pieterpottie/flim-transport-project/Documents/designReport_2.docx

Department of Mechanical Engineering

Engr 466 Design Report 2

Authors: | Anderson Li Andrew Bornstein
Filename: | designReport_1
Date: | 25-May-2012
Total Pages: | 32

Table of Contents

Table of Figures

List of Tables

# 1 Introduction

## 1.1 Current State of the Project

## 1.2 Objectives of this Report

KEEP THINGS CONCISE. GO THROUGH THE DESIGN IN DETAIL BUT ONLY SAY WHAT YOU HAVE TO. SAY IT DIRECTLY AND SIMPLY.

# 2 Final Design Description

This section should be pretty short. Give a detailed description of how each design component will operate and the parts that make it up. keep it brief and general. Tell them what the component is, what it does, the parts that make it up to achieve its purpose

-Film transport

-2 sprockets, R=23.8mm. cnc milled from aluminum

-driven by a stepper motor.. 50 steps per frame. Stepper motor circuit…independent control diagram…(or should this be in the later sections…)…

-Up/outtake

-film gate

-tensioner

-LED illumination

-photo mount

-frame layout (this can mostly go in design mechanical interfacing)

…. maybe

# 3 Detailed Mechanical Overview

Drawings for each mechanical component

Describe how things attach, bolt sizes ect.

Assembly drawing of the system

# 4 Design Component Interfacing

…the mechanical interfacing.. spacing between film gate and sprockets.. how things are layed out on the frame ex, so the tensioner will fit and operate. (basically a detailed discussion of the frame)

Identify all the interface circuits

Identify the software relationships between

# 5 Electrical Design

-individual circuits and the power requirements, operating parameters for our actuators/sensors

-giant system circuit

# 6 Preliminary Software Design

-system flow chart

-flow chart for the components (like in that 230 assignment)

# 7 Conclusions

-current challenges we are facing and how we are attacking it.

-our next steps

# References

1. EarthEasy. [Online] [Cited: May 24, 2012.] http://eartheasy.com/live_led_bulbs_comparison.html.

2. Flatbed Scanner Digital Telecine (FSDT) Project. [Online] [Cited: May 25, 2012.]

http://www.truetex.com/telecine.htm.

3.Machinist-Materials, Plastics Comparison Table [Online] [Cited: May 25, 2012] http://www.machinist-materials.com/comparison_table_for_plastics.htm.

4. Omnia Plastica ABS Acrylonitrile-butadiene-styrene. [Online][Cited: May 25, 2012] http://www.matweb.com/search/datasheet.aspx?matguid=f6c2155e247b427d8bedaad7620b4c37&ckck=1.

5. 1 -1/4” Chigaco Screws. [Online][Cited: May 25, 2012] http://www.screwpost.com/product_info.php?cPath=1&products_id=10

6. 1/8” Aluminum Rod Stock. [Online][Cited: May 25, 2012]

http://www.mcmaster.com/#standard-aluminum-rods/=hoo0rc

Engr 466 Design Report 1 Date: 25-May-2012
