pieterpottie/flim-transport-project/Weekly-Reports/Gantt-Chart.xlsx

VX42 (http://www.vertex42.com/ExcelTemplates/excel-gantt-chart.html) | Excel Gantt Chart |  |  |  |  | © 2006 Vertex42 LLC (http://www.vertex42.com/terms.html) | v.1.2
Engr 466 Flim Transport Project
Department of Mechanical Engineering
 | Project Lead:
 | Today's Date: | 2012-07-17 |  | (vertical red line)
 | Viewing Weeks: | 5/7/12 - 4/1/13 |  |  |  |  |  |  |  | 0 | 2012-05-07 | 2012-05-08 | 2012-05-09 | 2012-05-10 | 2012-05-11 | 2012-05-14 | 2012-05-15 | 2012-05-16 | 2012-05-17 | 2012-05-18 | 2012-05-21 | 2012-05-22 | 2012-05-23 | 2012-05-24 | 2012-05-25 | 2012-05-28 | 2012-05-29 | 2012-05-30 | 2012-05-31 | 2012-06-01 | 2012-06-04 | 2012-06-05 | 2012-06-06 | 2012-06-07 | 2012-06-08 | 2012-06-11 | 2012-06-12 | 2012-06-13 | 2012-06-14 | 2012-06-15 | 2012-06-18 | 2012-06-19 | 2012-06-20 | 2012-06-21 | 2012-06-22 | 2012-06-25 | 2012-06-26 | 2012-06-27 | 2012-06-28 | 2012-06-29 | 2012-07-02 | 2012-07-03 | 2012-07-04 | 2012-07-05 | 2012-07-06 | 2012-07-09 | 2012-07-10 | 2012-07-11 | 2012-07-12
WBS | Tasks | Task Lead | Start | End | Duration (Days) | % Complete | Working Days | Days Complete | Days Remaining |  | 5/7/12 |  |  |  |  | 5/14/12 |  |  |  |  | 5/21/12 |  |  |  |  | 5/28/12 |  |  |  |  | 6/4/12 |  |  |  |  | 6/11/12 |  |  |  |  | 6/18/12 |  |  |  |  | 6/25/12 |  |  |  |  | 7/2/12 |  |  |  |  | 7/9/12
 | Design Report 1 |  | 2012-05-07 | 2012-06-01 | 26 | 100% | 20 | 26 | 0
 | Background Research | Andrew | 2012-05-14 | 2012-05-16 | 3 | 100% | 3 | 3 | 0
 | Peripherals Research | Andrew | 2012-05-14 | 2012-05-19 | 6 | 100% | 5 | 6 | 0
 | Actuator Research | Andrew | 2012-05-14 | 2012-05-23 | 10 | 100% | 8 | 10 | 0
 | Sensor Research | Anderson | 2012-05-14 | 2012-05-23 | 10 | 100% | 8 | 10 | 0
 | Frame Design | Anderson & Andrew | 2012-05-14 | 2012-05-25 | 12 | 100% | 10 | 12 | 0
 | Mounting Design | Anderson | 2012-05-16 | 2012-05-25 | 10 | 100% | 8 | 10 | 0
 | Write Report | Anderson & Andrew | 2012-05-07 | 2012-05-25 | 19 | 100% | 15 | 19 | 0
 | Initial Design Concepts | Anderson & Andrew | 2012-05-14 | 2012-05-26 | 13 | 100% | 10 | 13 | 0
 | Client Presentation 1 | Anderson & Andrew | 2012-05-27 | 2012-06-01 | 6 | 100% | 5 | 6 | 0
 | Design Report 2 |  | 2012-05-25 | 2012-06-29 | 36 | 93.75% | 26 | 33 | 3
 | Order Parts | Andrew | 2012-05-25 | 2012-05-25 | 1 | 100% | 1 | 1 | 0
 | Programming | Anderson & Andrew | 2012-05-25 | 2012-06-18 | 25 | 85% | 17 | 21 | 4
 | Refine Design Models | Anderson & Andrew | 2012-06-04 | 2012-06-29 | 26 | 100% | 20 | 26 | 0
 | Setup Electronics | Anderson & Andrew | 2012-06-10 | 2012-06-29 | 20 | 85% | 15 | 17 | 3
 | Write Report | Anderson & Andrew | 2012-05-25 | 2012-06-29 | 36 | 100% | 26 | 36 | 0
 | Prototype Demo |  | 2012-06-08 | 2012-08-03 | 57 | 41.42857143% | 41 | 23 | 34
 | Machine Parts | Anderson & Andrew | 2012-06-09 | 2012-06-24 | 16 | 95% | 10 | 15 | 1
 | Assembly | TBA | 2012-07-04 | 2012-07-13 | 10 | 35% | 8 | 3 | 7
 | Troubleshoot | TBA | 2012-07-13 | 2012-07-27 | 15 | 30% | 11 | 4 | 11
 | Client Presentation 2 | TBA | 2012-07-20 | 2012-08-03 | 15 | 0% | 11 | 0 | 15
 | Final report |  | 2012-07-27 | 2012-08-04 | 9 | 0% | 6 | 0 | 9
 | Write Report | TBA | 2012-07-27 | 2012-08-04 | 9 | 0% | 6 | 0 | 9
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
