pieterpottie/flim-transport-project/Design-Reports/Report-1/comparison-charts.xlsx

 | Frame Precision | Ease of Manufacture | Size | Tooth/film contact ratio | Minimize stress applied to film | Total Score
Small Sproket | 9 | 2 | 9 | 2 | 2 | 24
Medium Sproket | 7 | 3 | 7 | 7 | 6 | 30
Large Sproket | 3 | 4 | 3 | 9 | 9 | 28
Max Score | 10 | 10 | 10 | 10 | 10
 | Low Cost | Time it takes to make parts | Minimize friction applied to film | Total Score
Pins | 10 | 8 | 2 | 20
Purchased Sleeve Bearings | 2 | 10 | 15 | 27
Machined Sleeve Bearings | 10 | 4 | 17 | 31
Max Score | 10 | 10 | 20
 | Frame Transport Accuracy | Low Cost | Ease of Machining and Assembly | Available Feedback | Minimize stress applied to film | Total Score
Stepper Motor | 8 | 9 | 9 | 0 | 5 | 31
Geneva Mechanism | 3 | 3 | 5 | 0 | 2 | 13
Servo Motor | 3 | 4 | 3 | 10 | 5 | 25
Max Score | 10 | 10 | 10 | 10 | 10
 | Low Cost | Easy Control System | Minimize Friction applied to film | Total Score
Tension Sensor | 1 | 3 | 2 | 6
Optical Encoder | 10 | 8 | 10 | 28
Max Score | 10 | 10 | 10
