pieterpottie/flim-transport-project/Models/A002_Film-Gate/A002_assemDesign1.SLDASM

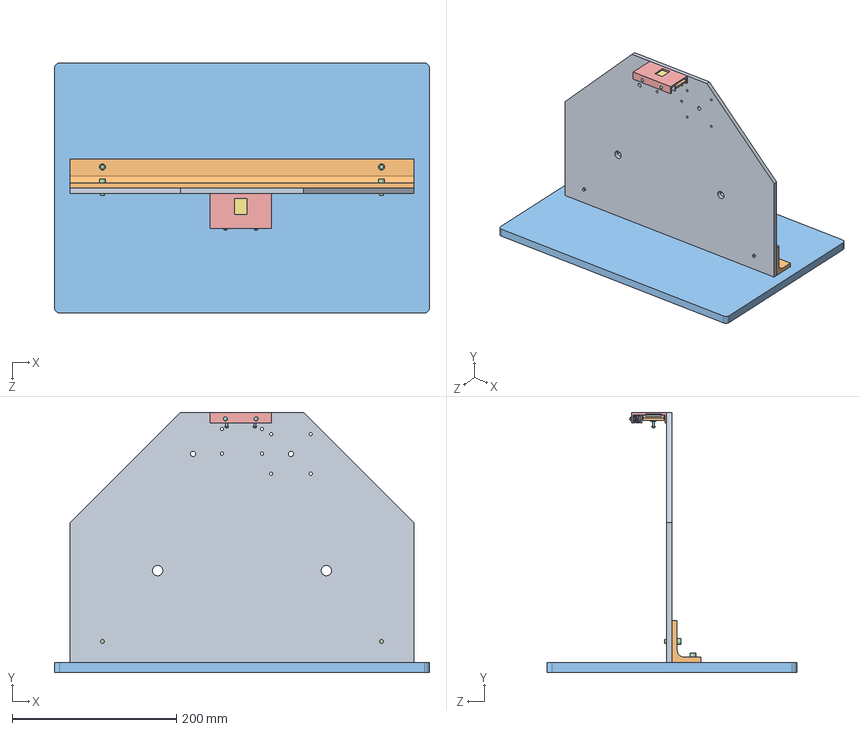
[picture p156: CAD file, 2012-05-22]
Models/A002_Film-Gate/A002_assemDesign1.SLDASM
457.2 x 317.5 x 304.8 mm
A001_frame
A001_LBracket
A001_base
A001_screw x 4
A002-B001_base
A002-B001_tensioner
virtualFilmModel^A002-B001_assem
A002-B001_screw x 4
A002-B001_spring x 2
A002-B001_topTensioner
