pieterpottie/flim-transport-project/Models/A002_Film-Gate/B001_Design-1/A002-B001_assem.SLDASM

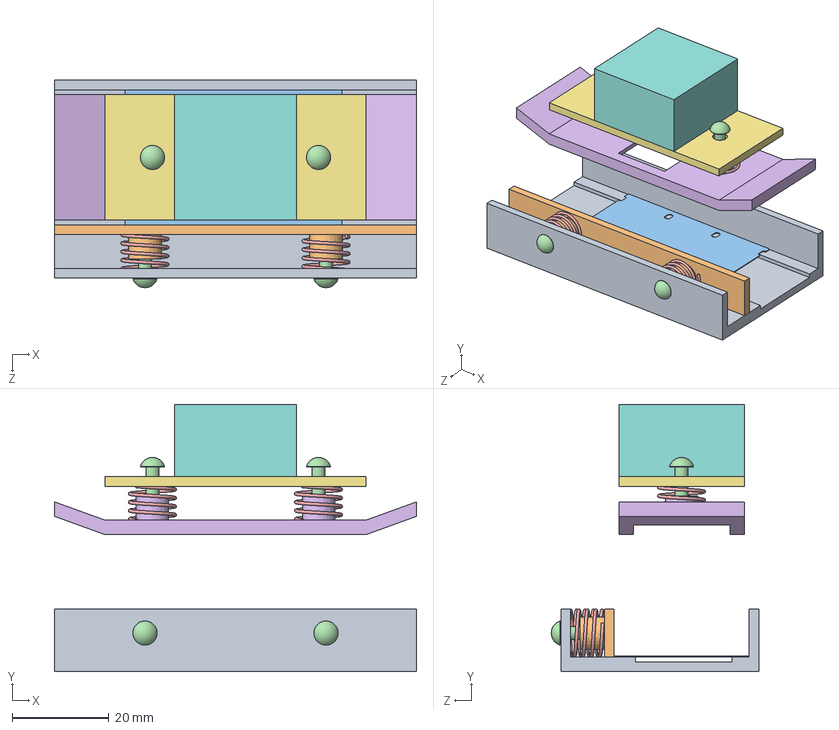
[picture p157: CAD file, 2012-05-23]
Models/A002_Film-Gate/B001_Design-1/A002-B001_assem.SLDASM
75.0 x 55.4 x 43.0 mm
A002-B001_base
A002-B001_tensioner
virtualFilmModel^A002-B001_assem
A002-B001_screw x 4
A002-B001_spring x 4
A002-B001_topTensioner
A002-B001_LEDMount
A002-B001_LEDs
