pieterpottie/flim-transport-project/Models/A002_Film-Gate/B002_Design-2/A002-B002_assem.SLDASM

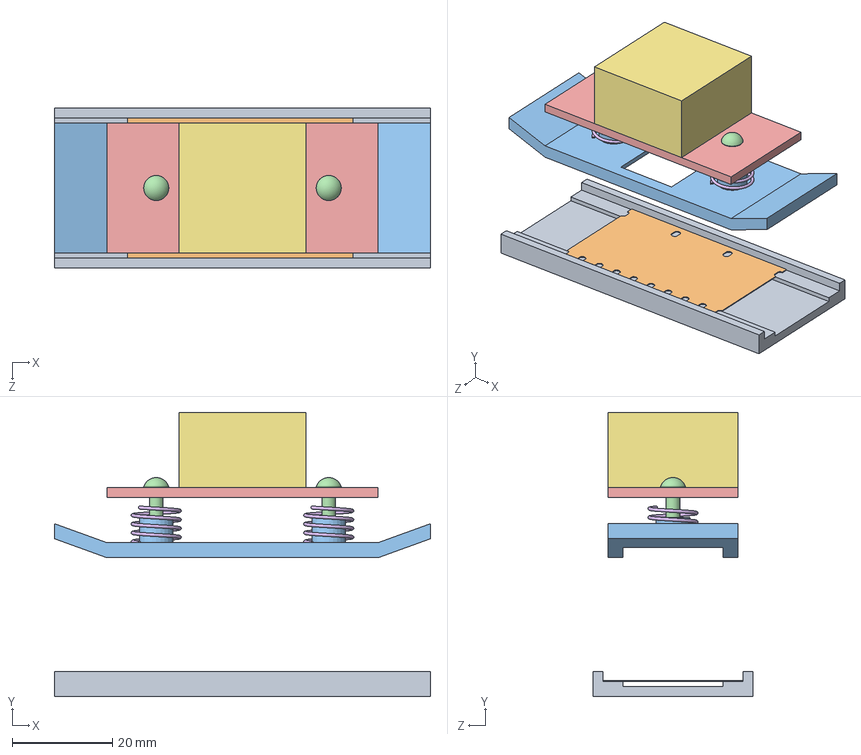
[picture p158: CAD file, 2012-05-24]
Models/A002_Film-Gate/B002_Design-2/A002-B002_assem.SLDASM
75.0 x 56.7 x 32.0 mm
A002-B002_base
virtualFilmModel^A002-B002_assem
A002-B002_topTensioner
A002-B002_screw x 2
A002-B002_LEDMount
A002-B002_spring x 2
A002-B002_LEDs
