pieterpottie/flim-transport-project/Models/A003_Frame-Designs/A003_FrameDesign2.SLDASM

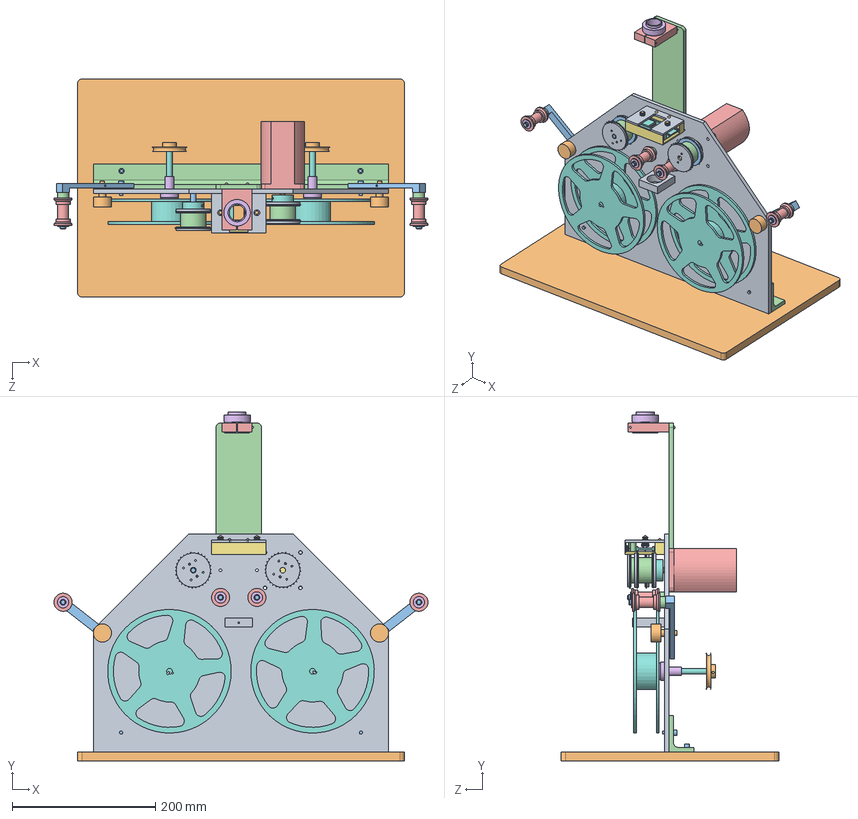
[picture p159: CAD file, 2012-08-03]
Models/A003_Frame-Designs/A003_FrameDesign2.SLDASM
522.9 x 487.8 x 304.8 mm
A001_frame
A001_base
A001_screw x 4
A001_LBracket
StepperModel
Brass_Bushing x 2
Coupling rod x 2
Coupler x 2
OuterSandwich_THICK x 4
R23.87mmSprocketCoarse x 2
OuterSandwich_THIN x 4
LongInnerSpacer x 2
R23.87mmSprocketFine x 2
Sprocket_Pin x 4
6-32_Set_Screw x 4
ReelRod x 2
ReelKey x 2
LargePulleyRoller x 2
RollerPin x 5
DelrinSpacer x 4
RollerPLASTICSECTION x 4
DelrinWasher x 4
A002-B003_base
A002-B003_topTensioner
A002-B003_TensionMount
A002-B003_screw x 6
A002-B003_spring x 2
A002-B003_tensioner x 2
A002-B003_spring-2 x 2
A002-B003_Post x 2
A002-B003_Brace x 2
FilmWheelModel x 2
A004_LED-Mount
Potentiometer x 2
A004_Tensioner-bracket x 2
A004_Adapter_Holder2
A004_Adapter_Holder
A004_Adapter
