pieterpottie/flim-transport-project/Models/A001_Frame-From-Art/A001_assem.SLDASM

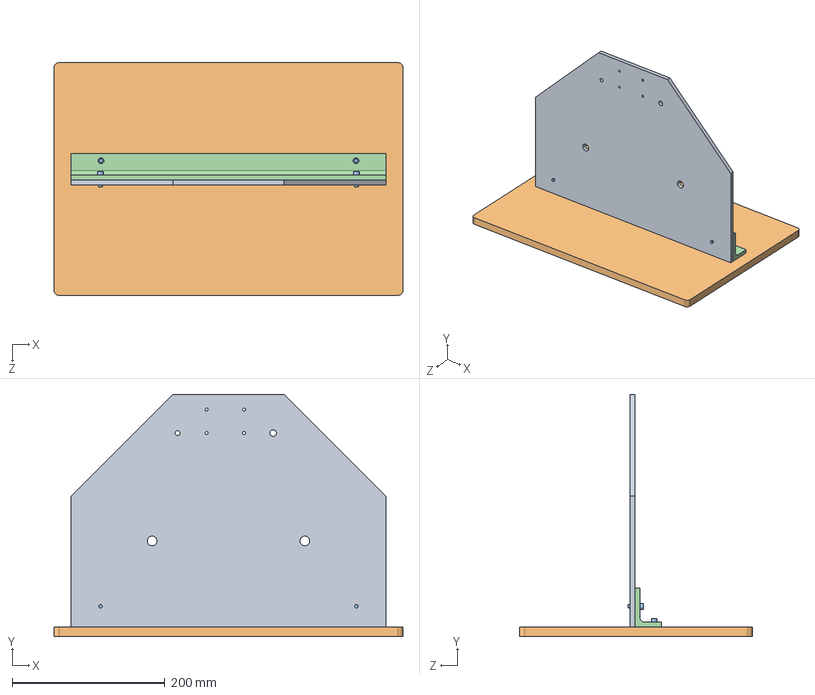
[picture p160: CAD file, 2012-07-12]
Models/A001_Frame-From-Art/A001_assem.SLDASM
457.2 x 317.5 x 304.8 mm
A001_frame
A001_base
A001_screw x 4
A001_LBracket
