pieterpottie/flim-transport-project/Andrew Models Import/TelecineAssembly.SLDASM

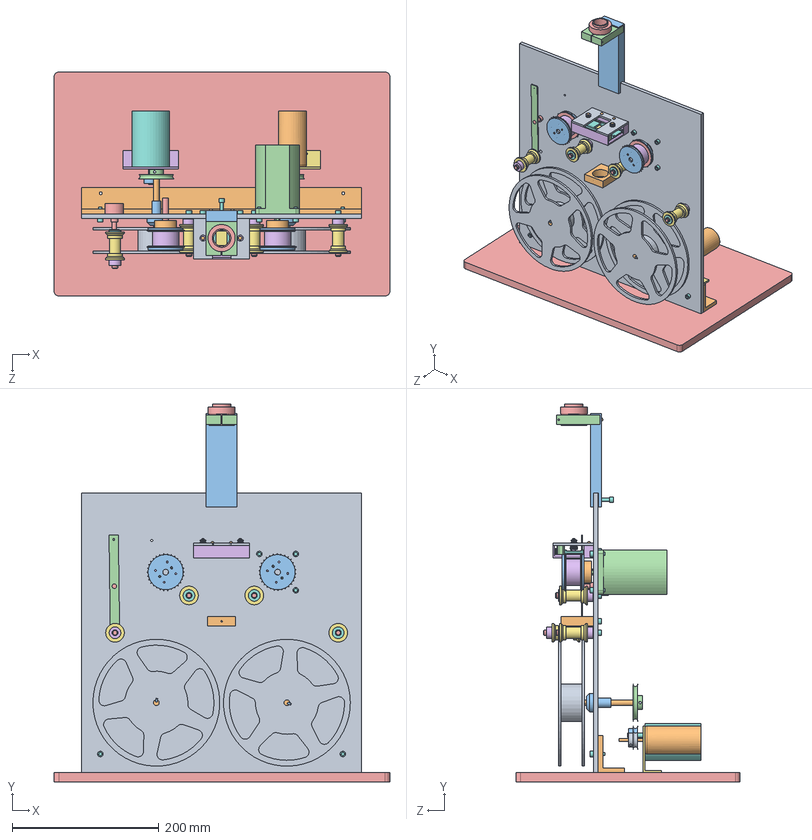
[picture p161: CAD file, 2012-07-12]
Andrew Models Import/TelecineAssembly.SLDASM
457.2 x 514.7 x 304.8 mm
Frame
StructureAngle
Brass_Bushing x 2
StepperModel
RollerPin x 5
DelrinSpacer x 4
RollerPLASTICSECTION x 4
DelrinWasher x 4
Coupling rod x 2
Coupler x 2
OuterSandwich_THICK x 4
R23.87mmSprocketCoarse x 2
OuterSandwich_THIN x 4
LongInnerSpacer x 2
R23.87mmSprocketFine x 2
Sprocket_Pin x 4
6-32_Set_Screw x 6
ReelRod x 2
ReelKey x 2
LargePulleyRoller x 2
GE_restricted
Wimpy_Faithful
Ge_Motor
SmallPulleyRoller_4mm
Wimpy_Motor
SmallPulleyRoller
TensionArm
Potentiometer
A002-B003_base
virtualFilmModel^A002-B003_assem
A002-B003_topTensioner
A002-B003_TensionMount
A002-B003_screw x 6
A002-B003_spring x 2
A002-B003_tensioner x 2
A002-B003_spring-2 x 2
A002-B003_Post x 2
A002-B003_Brace x 2
A001_screw x 13
FilmWheelModel x 2
A004_LED-Mount
A004_Adapter_Holder2
A004_Adapter_Holder
A004_Adapter
