pieterpottie/flim-transport-project/Models/A003_Frame-Designs/A003_Existing_Art_Frame.SLDASM

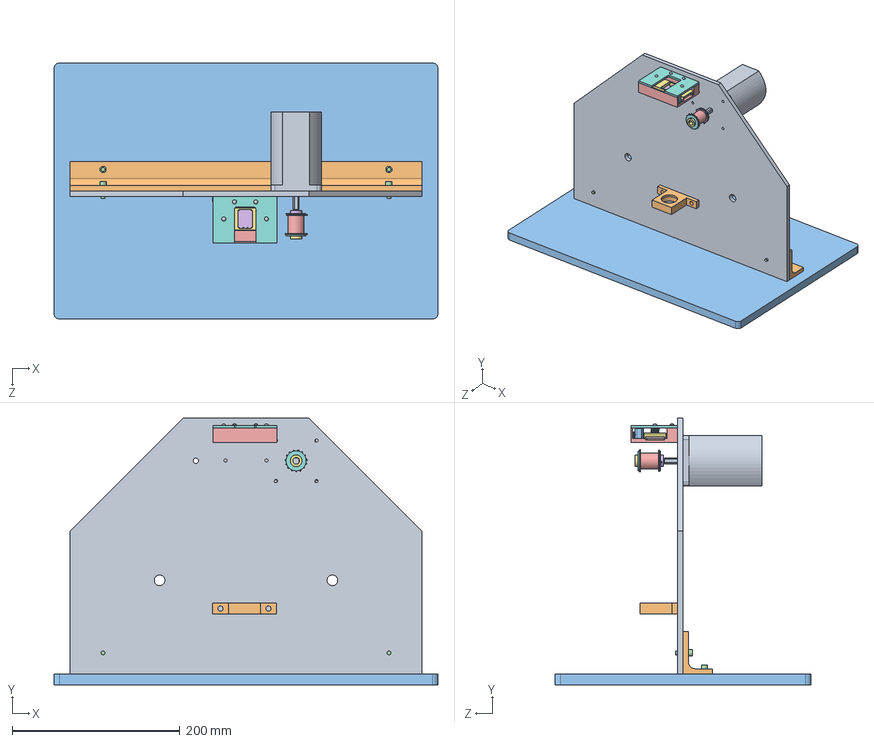
[picture p162: CAD file, 2012-06-18]
Models/A003_Frame-Designs/A003_Existing_Art_Frame.SLDASM
457.2 x 317.5 x 304.8 mm
A001_frame
A001_LBracket
A001_base
A001_screw x 4
A002-B003_base
virtualFilmModel^A002-B003_assem
A002-B003_topTensioner
A002-B003_TensionMount
A002-B003_screw x 4
A002-B003_spring x 2
A002-B003_tensioner x 2
A002-B003_spring-2 x 2
innerSandwich_3quarterdia_looseFit
MajorSprocket23mm
MinorSprocket23mm
OuterSandwich_PressFit x 2
StepperModel
A004_LED-Mount
