pieterpottie/flim-transport-project/Models/A002_Film-Gate/B003_Design-3/A002-B003_assem.SLDASM

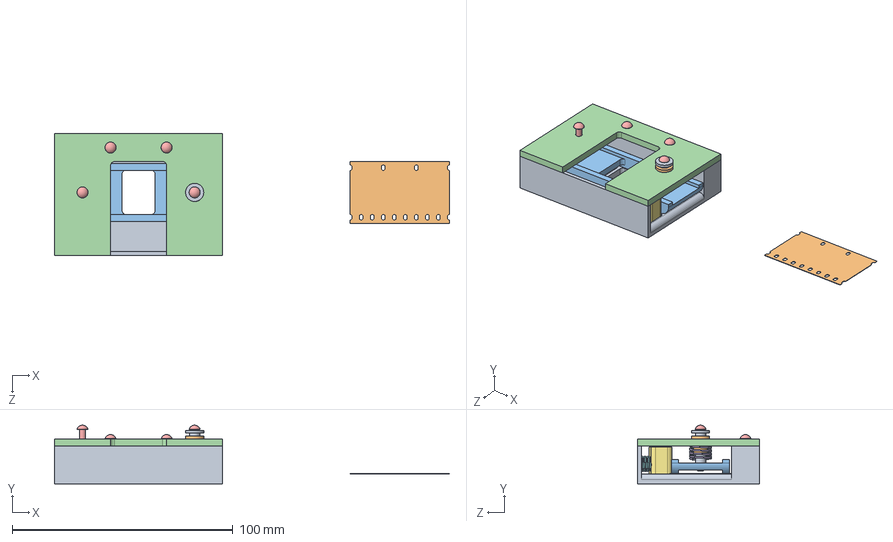
[picture p163: CAD file, 2012-08-03]
Models/A002_Film-Gate/B003_Design-3/A002-B003_assem.SLDASM
178.9 x 26.6 x 55.2 mm
A002-B003_base
virtualFilmModel
A002-B003_topTensioner
A002-B003_TensionMount
A002-B003_screw x 4
A002-B003_spring x 2
A002-B003_tensioner x 2
A002-B003_spring-2 x 2
