pieterpottie/flim-transport-project/Models/A004_Mounts/A004_CameraAssembly.SLDASM

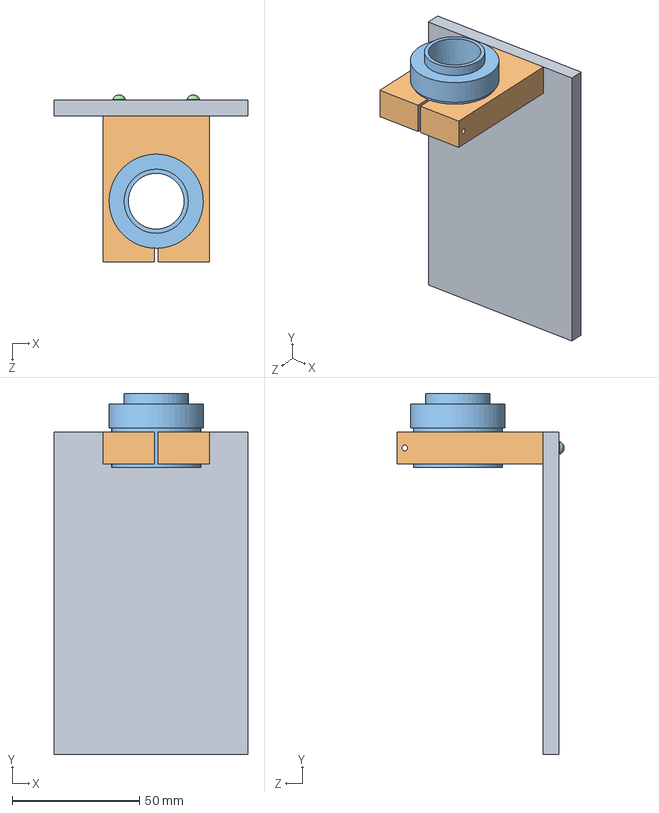
[picture p164: CAD file, 2012-07-12]
Models/A004_Mounts/A004_CameraAssembly.SLDASM
76.2 x 142.1 x 65.9 mm
A004_Adapter_Holder2
A004_Adapter_Holder
A004_Adapter
A002-B003_screw x 2
