pieterpottie/flim-transport-project/Andrew Models Import/ReelAssembly.SLDASM

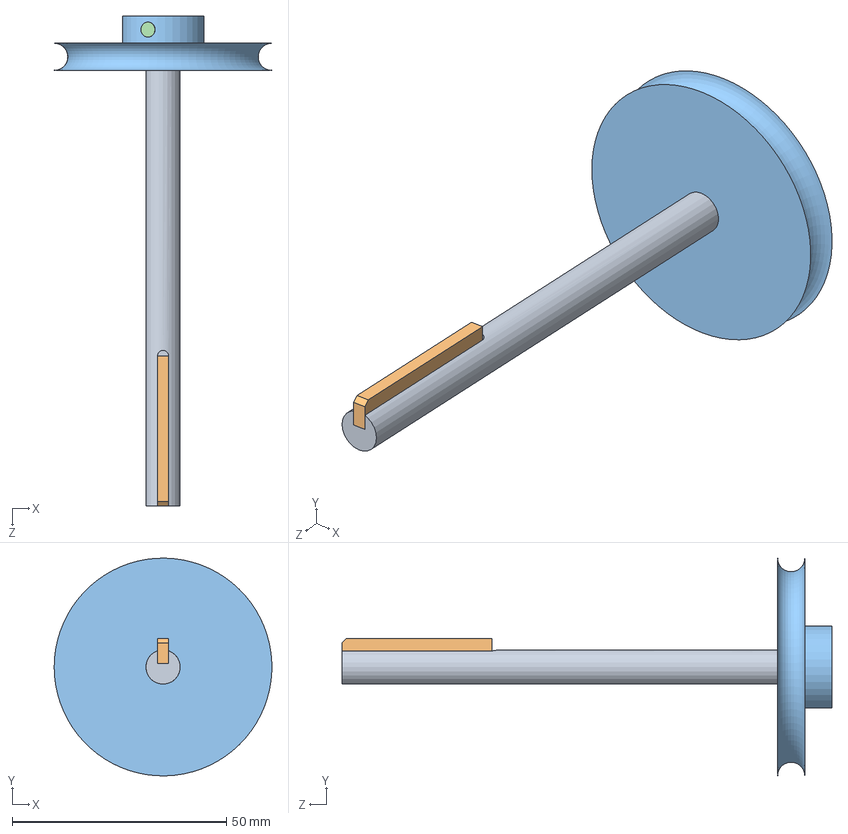
[picture p165: CAD file, 2012-07-03]
Andrew Models Import/ReelAssembly.SLDASM
50.8 x 50.8 x 114.3 mm
ReelRod
ReelKey
LargePulleyRoller
6-32_Set_Screw
