pieterpottie/flim-transport-project/Andrew Models Import/SprocketAssembly.SLDASM

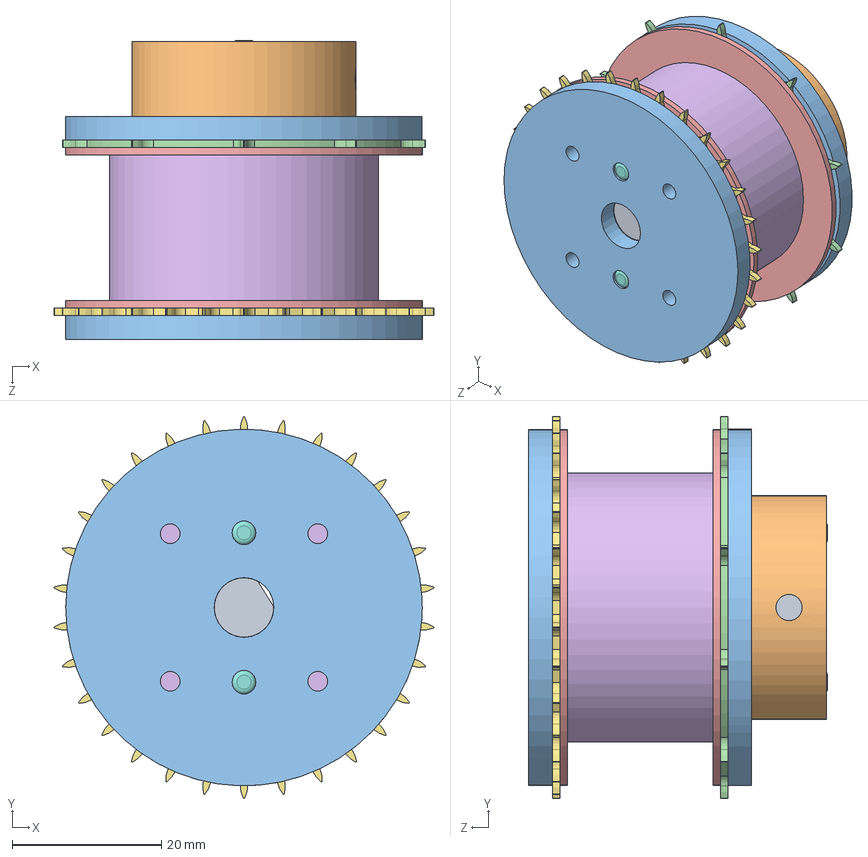
[picture p166: CAD file, 2012-07-03]
Andrew Models Import/SprocketAssembly.SLDASM
50.9 x 51.2 x 40.0 mm
Coupling rod
Coupler
OuterSandwich_THICK x 2
R23.87mmSprocketCoarse
OuterSandwich_THIN x 2
LongInnerSpacer
R23.87mmSprocketFine
Sprocket_Pin x 2
6-32_Set_Screw
