pieterpottie/flim-transport-project/Andrew Models Import/Assem3.SLDASM

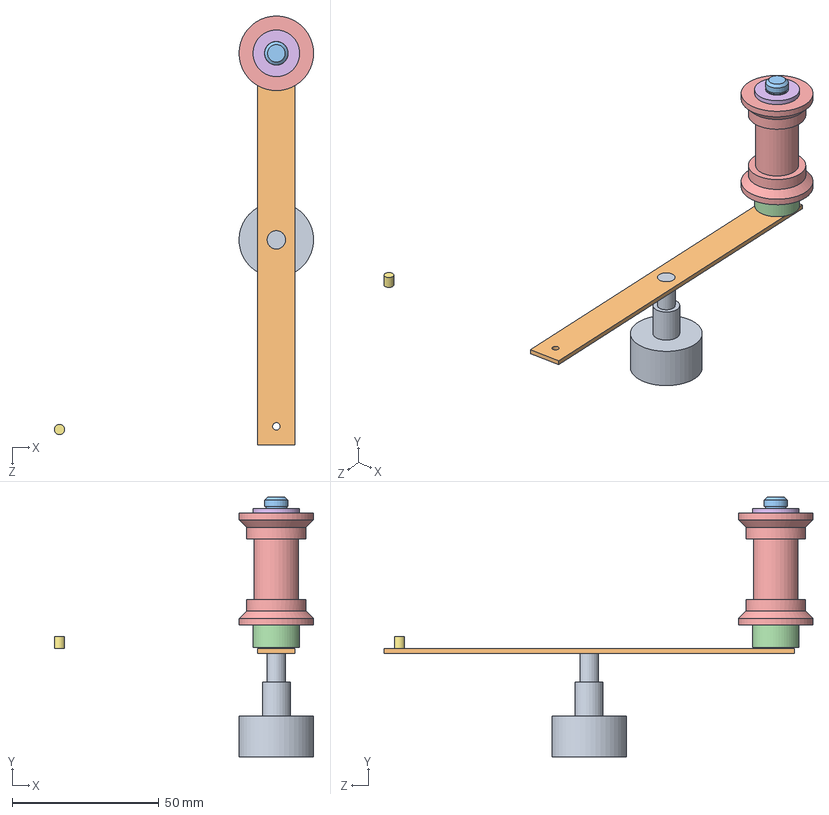
[picture p167: CAD file, 2012-07-03]
Andrew Models Import/Assem3.SLDASM
88.3 x 88.4 x 146.1 mm
Potentiometer
TensionArm
RollerPin
DelrinSpacer
RollerPLASTICSECTION
DelrinWasher
6-32_Set_Screw
