pieterpottie/flim-transport-project/Andrew Models Import/RollerAssembly.SLDASM

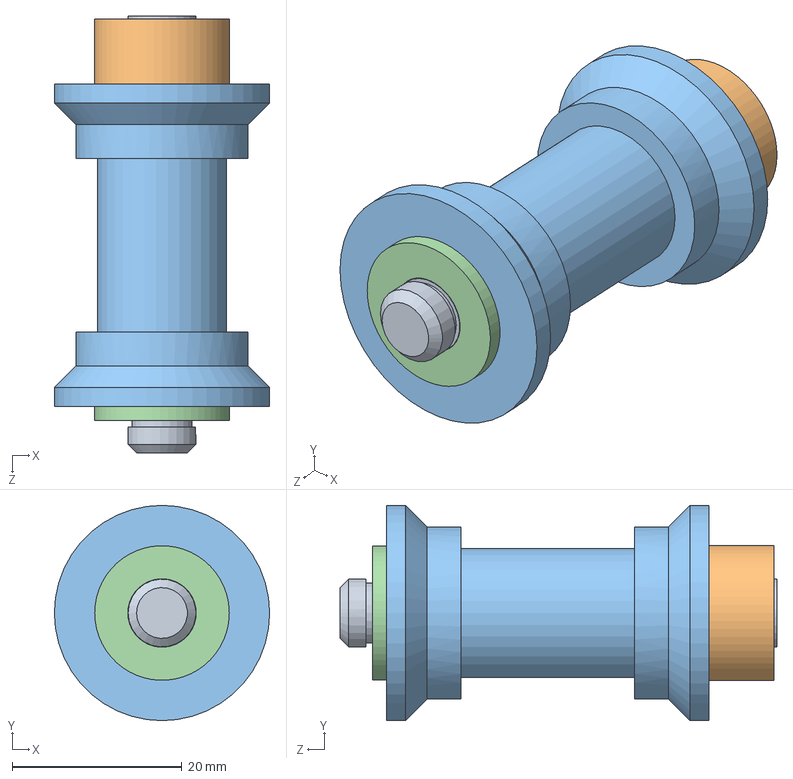
[picture p168: CAD file, 2012-07-03]
Andrew Models Import/RollerAssembly.SLDASM
25.4 x 25.4 x 51.6 mm
RollerPin
DelrinSpacer
RollerPLASTICSECTION
DelrinWasher
