pieterpottie/flim-transport-project/Andrew Models Import/Frame_Assembly.SLDASM

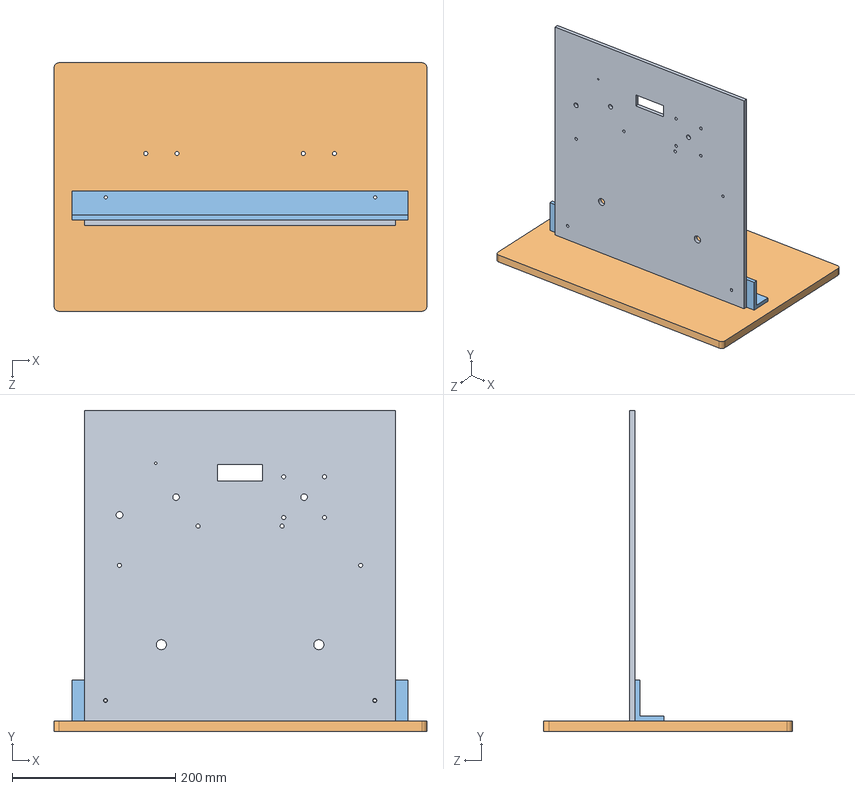
[picture p169: CAD file, 2012-07-03]
Andrew Models Import/Frame_Assembly.SLDASM
457.2 x 393.7 x 304.8 mm
Frame
Base
StructureAngle
