pieterpottie/flim-transport-project/Andrew Models Import/ANDREW_DCMOTOR_MOUNTS/Base.SLDPRT

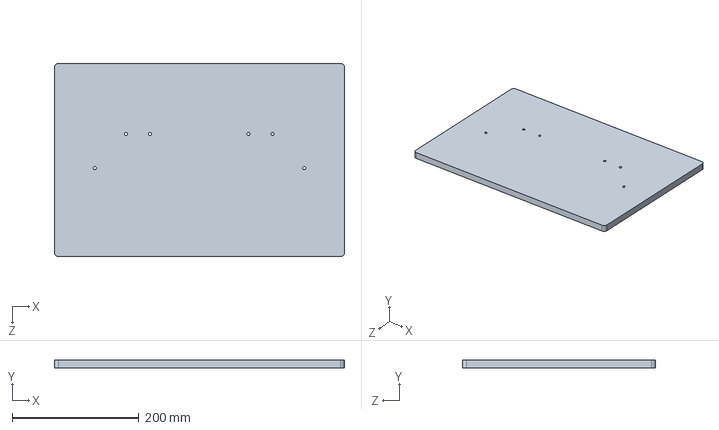
[picture p170: CAD file, 2012-07-05]
Andrew Models Import/ANDREW_DCMOTOR_MOUNTS/Base.SLDPRT
457.2 x 12.7 x 304.8 mm
