pieterpottie/flim-transport-project/Andrew Models Import/Brass_Bushing.SLDPRT

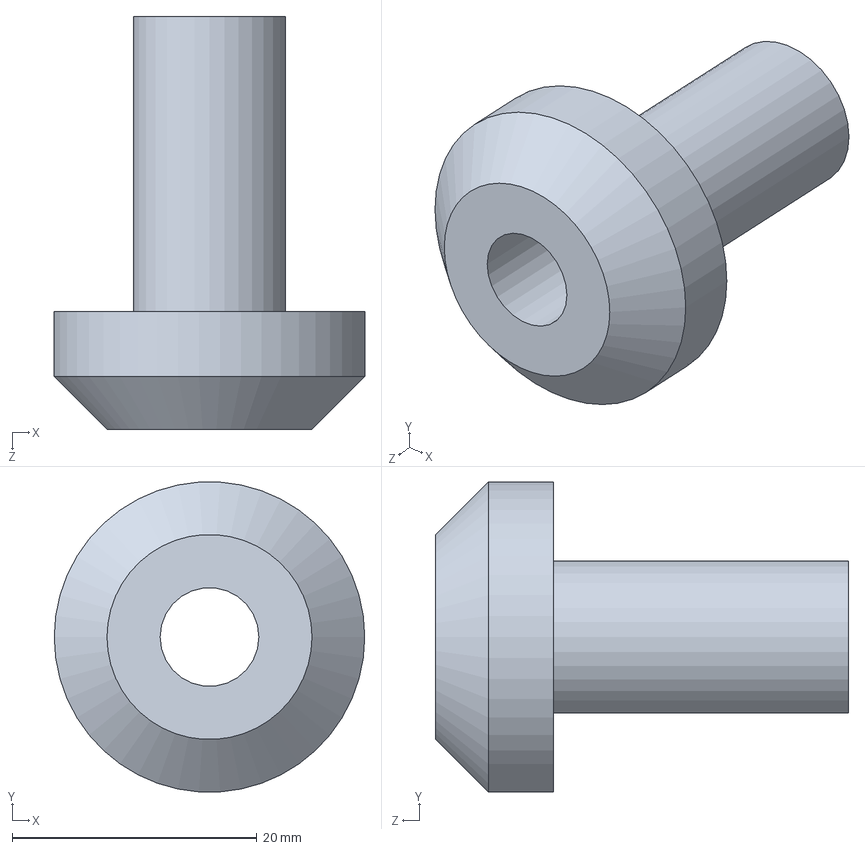
[picture p171: CAD file, 2012-07-12]
Andrew Models Import/Brass_Bushing.SLDPRT
25.4 x 25.3 x 33.8 mm
