pieterpottie/flim-transport-project/Andrew Models Import/PrintSprock/OuterSandwich_PressFit.SLDPRT.STL

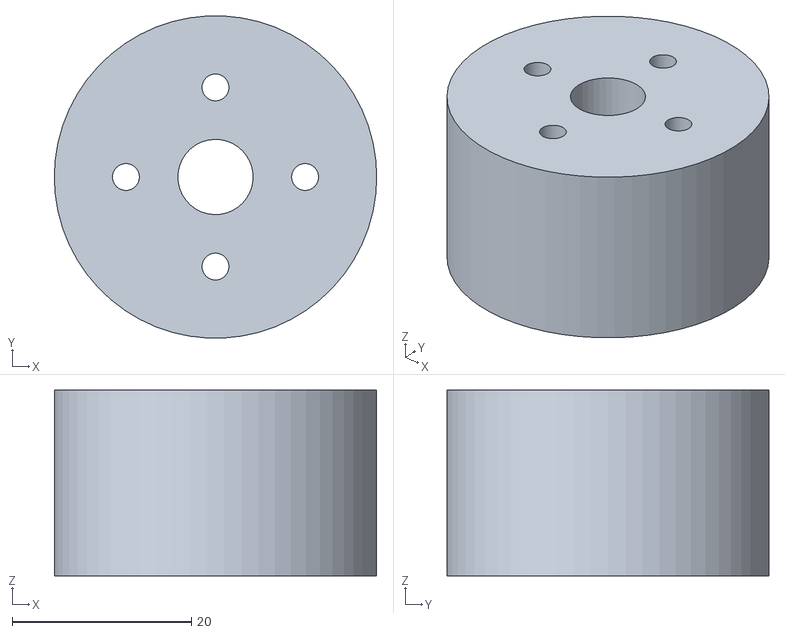
[picture p172: CAD file, 2012-07-03]
Andrew Models Import/PrintSprock/OuterSandwich_PressFit.SLDPRT.STL
36.0 x 35.9 x 20.7
