pieterpottie/flim-transport-project/Models/A001_Frame-From-Art/A001_frame.SLDPRT

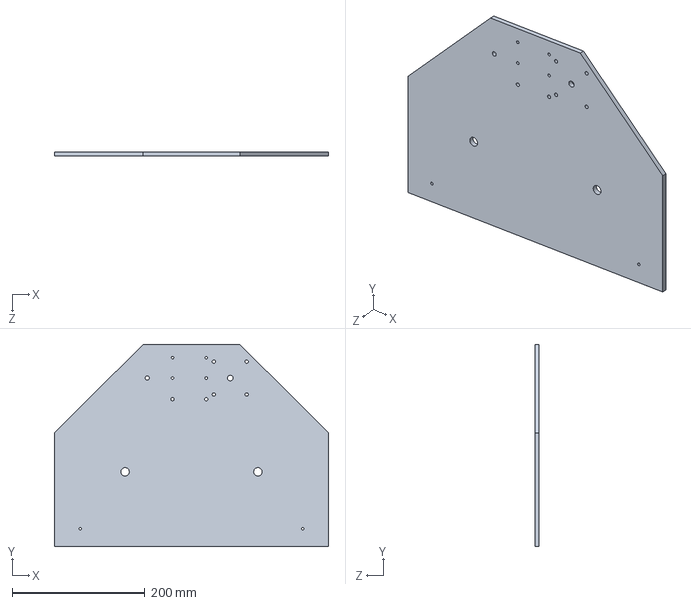
[picture p173: CAD file, 2012-07-12]
Models/A001_Frame-From-Art/A001_frame.SLDPRT
412.8 x 304.8 x 6.60 mm
