pieterpottie/flim-transport-project/Models/A002_Film-Gate/B003_Design-3/A002-B003_topTensioner.sldprt

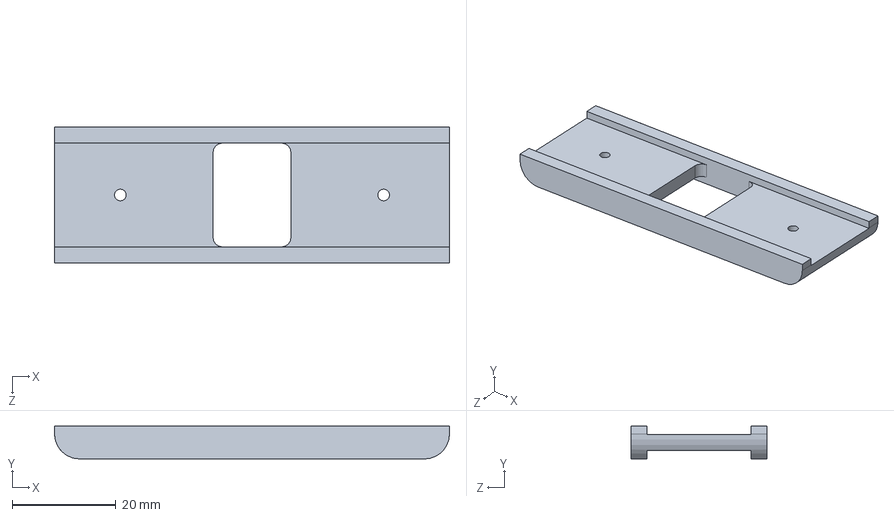
[picture p174: CAD file, 2012-08-03]
Models/A002_Film-Gate/B003_Design-3/A002-B003_topTensioner.sldprt
76.2 x 6.35 x 26.2 mm
