pieterpottie/flim-transport-project/Models/A004_Mounts/A004_Adapter_Holder.SLDPRT

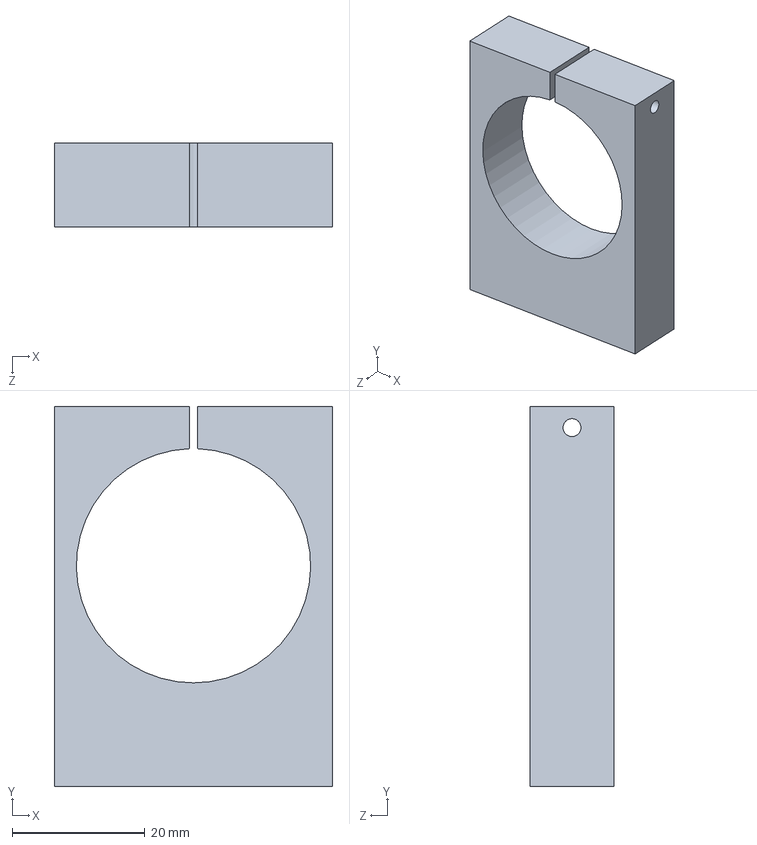
[picture p175: CAD file, 2012-08-03]
Models/A004_Mounts/A004_Adapter_Holder.SLDPRT
41.9 x 57.3 x 12.7 mm
