pieterpottie/flim-transport-project/Models/FilmWheelModel.SLDPRT

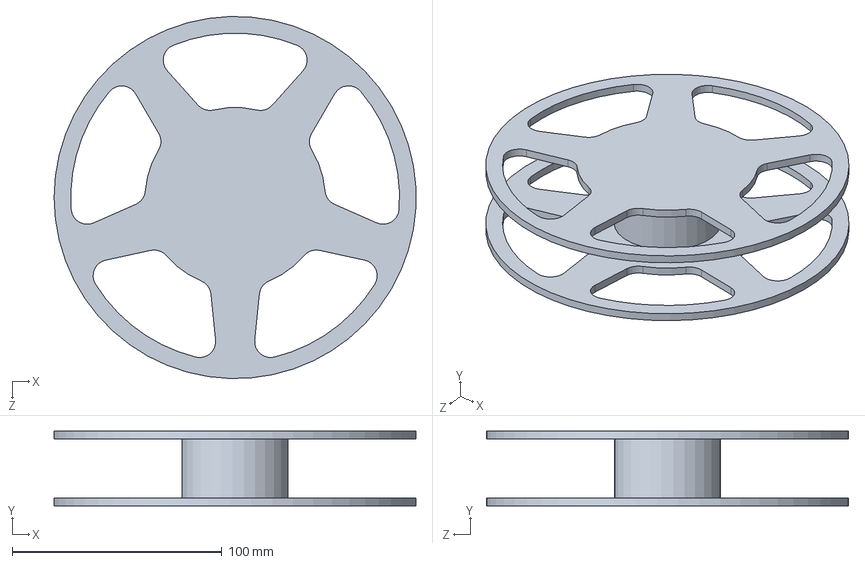
[picture p176: CAD file, 2012-07-05]
Models/FilmWheelModel.SLDPRT
172.6 x 35.6 x 172.6 mm
