pieterpottie/flim-transport-project/Andrew Models Import/ANDREW_DCMOTOR_MOUNTS/GE_restricted.SLDPRT

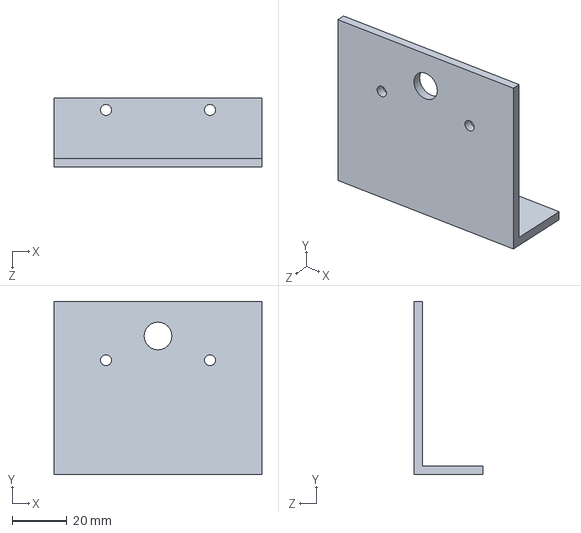
[picture p177: CAD file, 2012-07-05]
Andrew Models Import/ANDREW_DCMOTOR_MOUNTS/GE_restricted.SLDPRT
76.2 x 63.5 x 25.4 mm
