pieterpottie/flim-transport-project/Andrew Models Import/Frame.SLDPRT

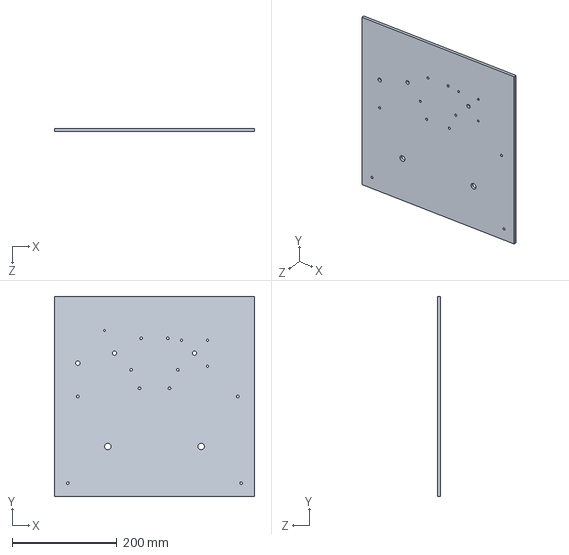
[picture p178: CAD file, 2012-07-12]
Andrew Models Import/Frame.SLDPRT
381.0 x 381.0 x 6.35 mm
