pieterpottie/flim-transport-project/Andrew Models Import/PrintSprock/R23.87mmSprocket.SLDPRT

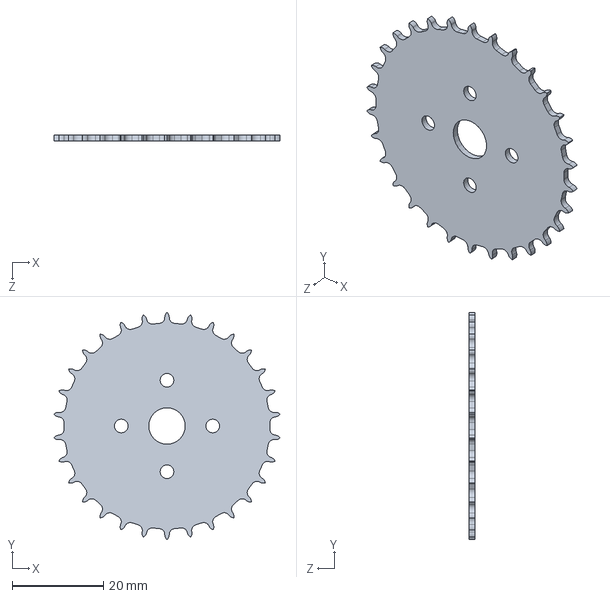
[picture p179: CAD file, 2012-07-03]
Andrew Models Import/PrintSprock/R23.87mmSprocket.SLDPRT
49.5 x 49.7 x 1.27 mm
