pieterpottie/flim-transport-project/Models/A002_Film-Gate/B001_Design-1/A002-B001_base.SLDPRT

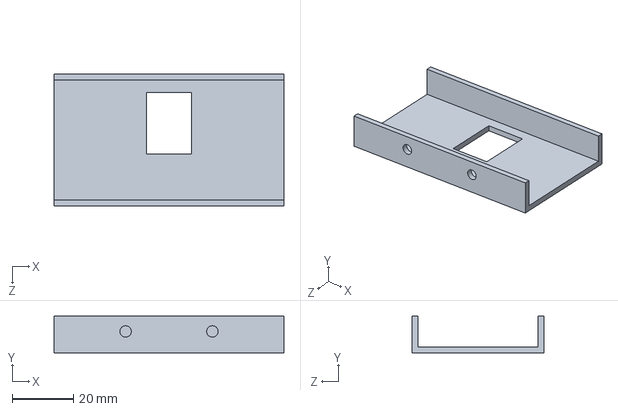
[picture p180: CAD file, 2012-05-22]
Models/A002_Film-Gate/B001_Design-1/A002-B001_base.SLDPRT
75.0 x 12.0 x 43.0 mm
