pieterpottie/flim-transport-project/Models/A002_Film-Gate/B003_Design-3/A002-B003_Post.SLDPRT

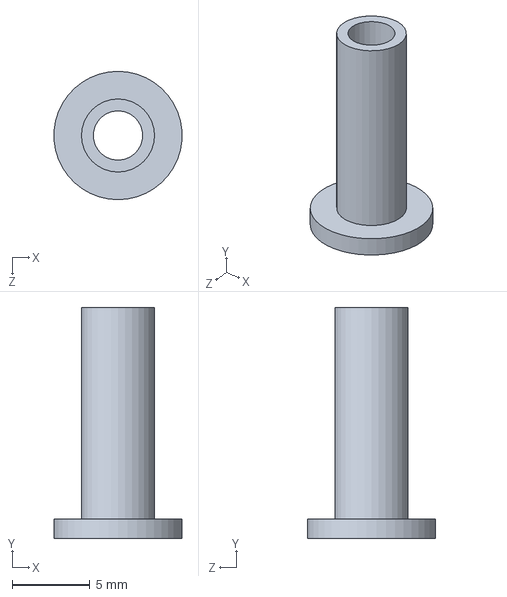
[picture p181: CAD file, 2012-08-03]
Models/A002_Film-Gate/B003_Design-3/A002-B003_Post.SLDPRT
8.23 x 14.9 x 8.26 mm
