pieterpottie/flim-transport-project/Models/A003_Frame-Designs/virtualFilmModel.sldprt

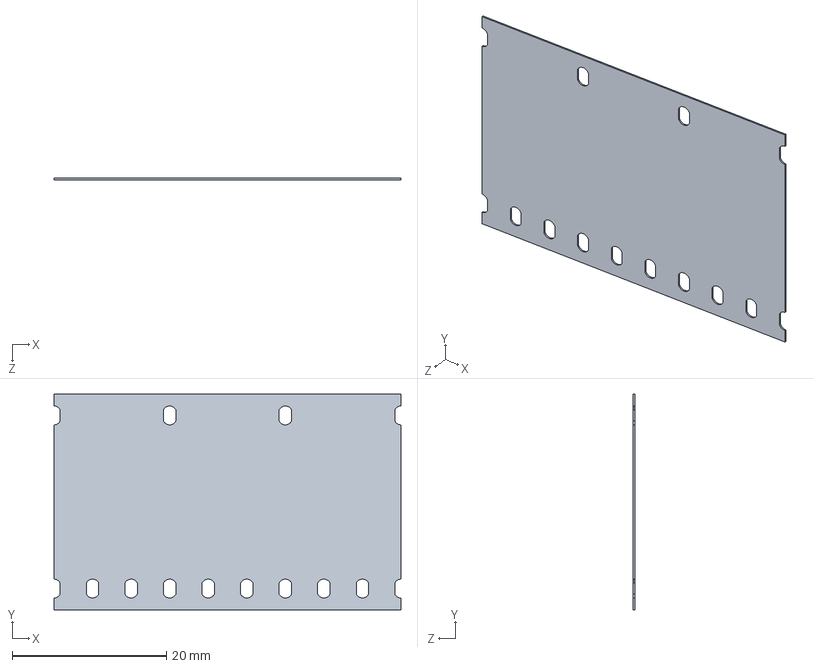
[picture p182: CAD file, 2012-08-03]
Models/A003_Frame-Designs/virtualFilmModel.sldprt
45.0 x 28.0 x 0.2 mm
