pieterpottie/flim-transport-project/Models/A004_Mounts/A004_Wheel_Adapter.SLDPRT

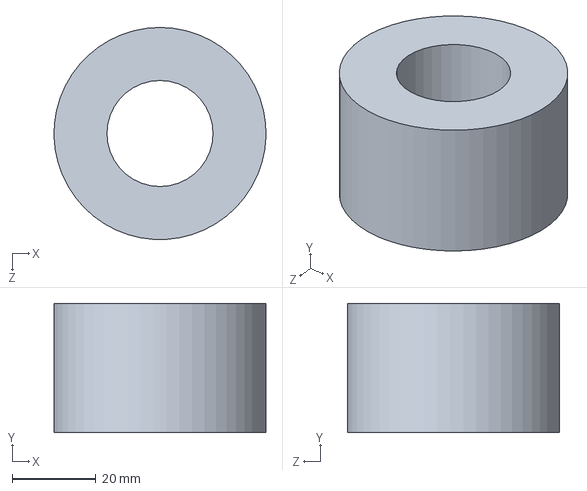
[picture p183: CAD file, 2012-08-03]
Models/A004_Mounts/A004_Wheel_Adapter.SLDPRT
50.8 x 31.0 x 50.8 mm
