pieterpottie/flim-transport-project/Models/A002_Film-Gate/B002_Design-2/A002-B002_spring.SLDPRT

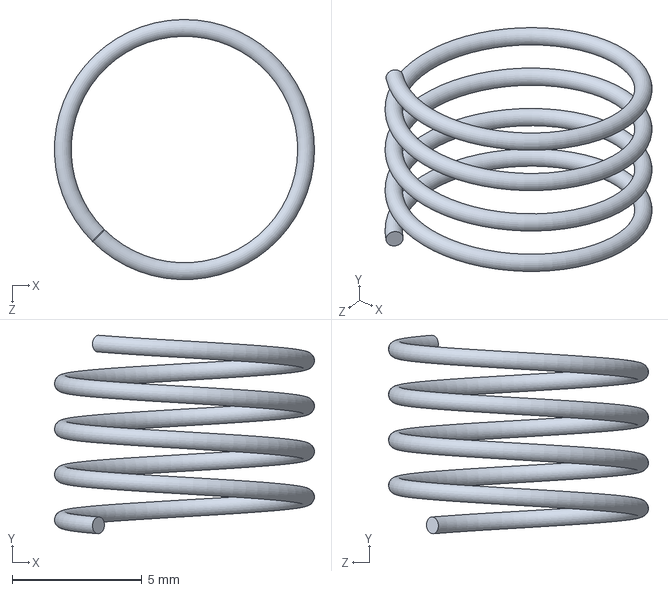
[picture p184: CAD file, 2012-05-23]
Models/A002_Film-Gate/B002_Design-2/A002-B002_spring.SLDPRT
10.0 x 7.65 x 10.0 mm
