pieterpottie/flim-transport-project/Models/A002_Film-Gate/B003_Design-3/A002-B003_TensionMount.SLDPRT

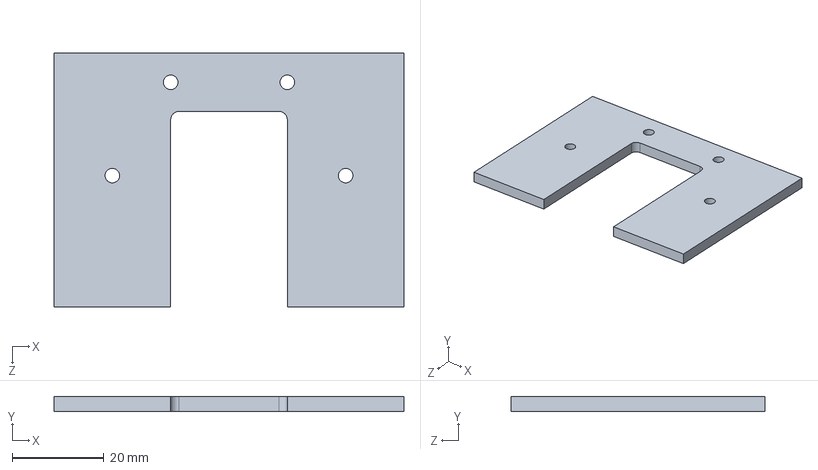
[picture p185: CAD file, 2012-08-03]
Models/A002_Film-Gate/B003_Design-3/A002-B003_TensionMount.SLDPRT
76.2 x 3.17 x 55.2 mm
