pieterpottie/flim-transport-project/Models/A004_Mounts/A004_Adapter.SLDPRT

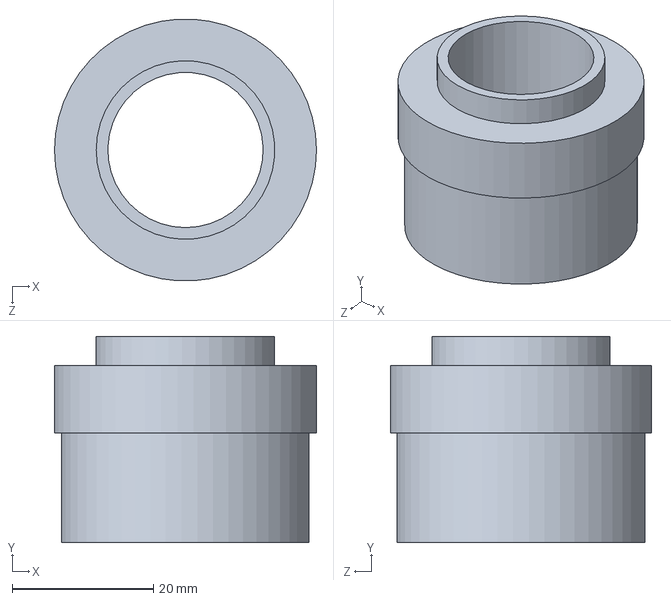
[picture p186: CAD file, 2012-07-12]
Models/A004_Mounts/A004_Adapter.SLDPRT
37.1 x 29.2 x 37.0 mm
