pieterpottie/flim-transport-project/Andrew Models Import/ANDREW_DCMOTOR_MOUNTS/Wimpy_Motor.SLDPRT

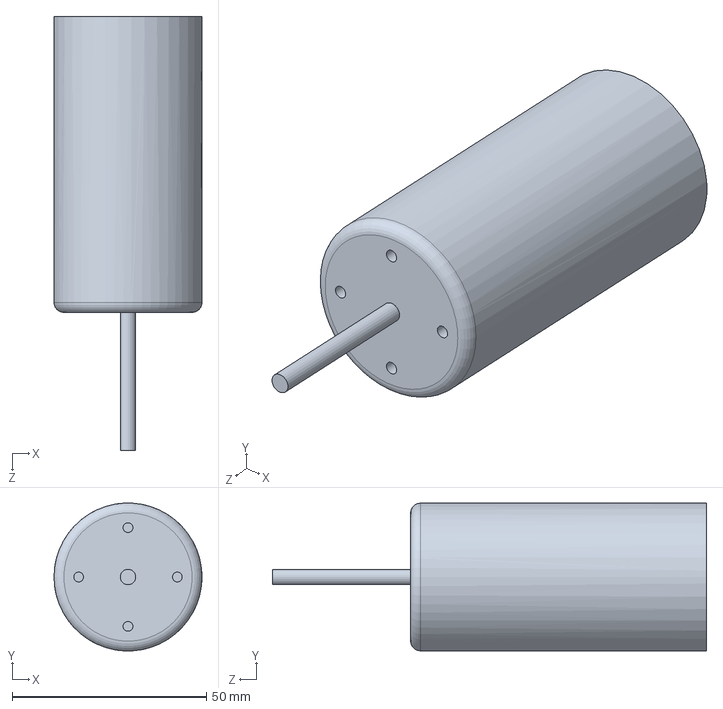
[picture p187: CAD file, 2012-07-03]
Andrew Models Import/ANDREW_DCMOTOR_MOUNTS/Wimpy_Motor.SLDPRT
38.1 x 38.1 x 111.8 mm
