pieterpottie/flim-transport-project/Andrew Models Import/PrintSprock/R23.87mmSprocketCoarse.SLDPRT

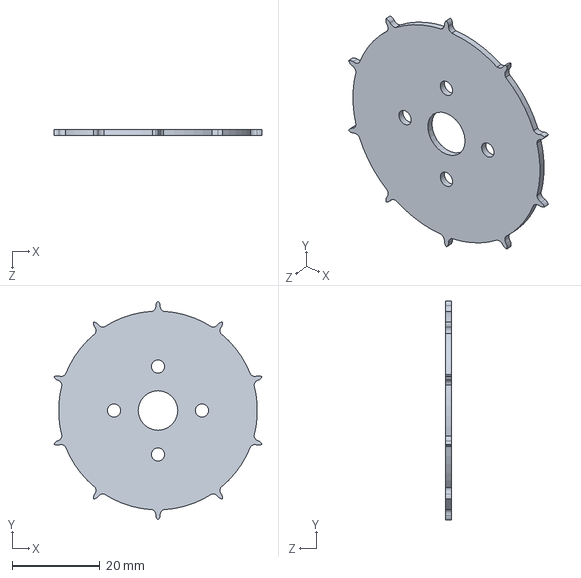
[picture p188: CAD file, 2012-07-03]
Andrew Models Import/PrintSprock/R23.87mmSprocketCoarse.SLDPRT
47.3 x 49.7 x 1.27 mm
