pieterpottie/flim-transport-project/Andrew Models Import/StepperModel.SLDPRT

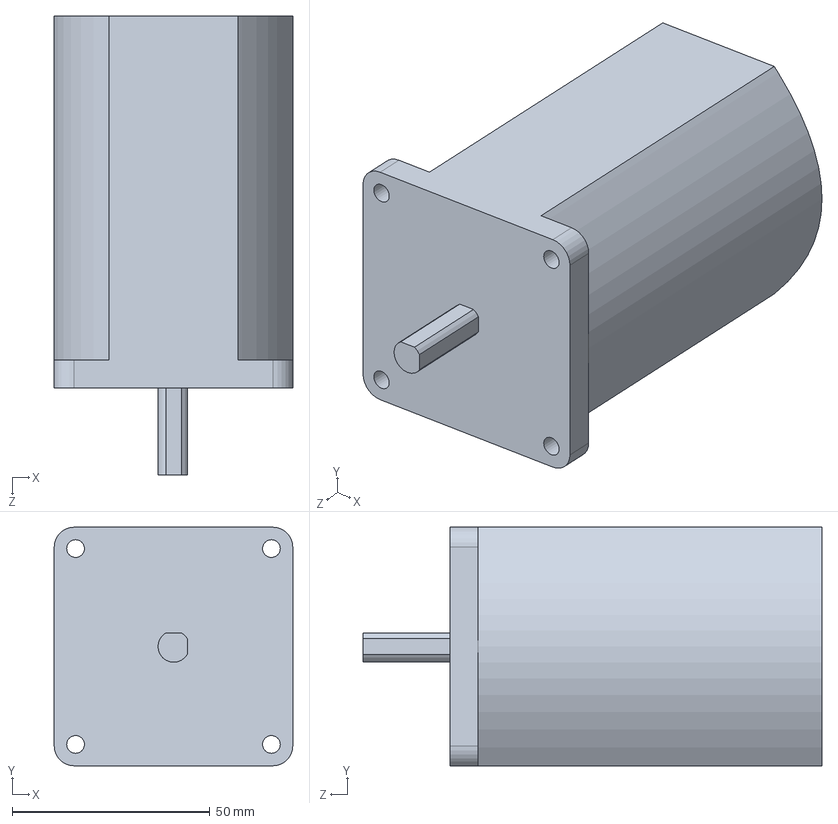
[picture p189: CAD file, 2012-07-05]
Andrew Models Import/StepperModel.SLDPRT
60.3 x 60.3 x 116.0 mm
