pieterpottie/flim-transport-project/Models/A001_Frame-From-Art/A001_LBracket.sldprt

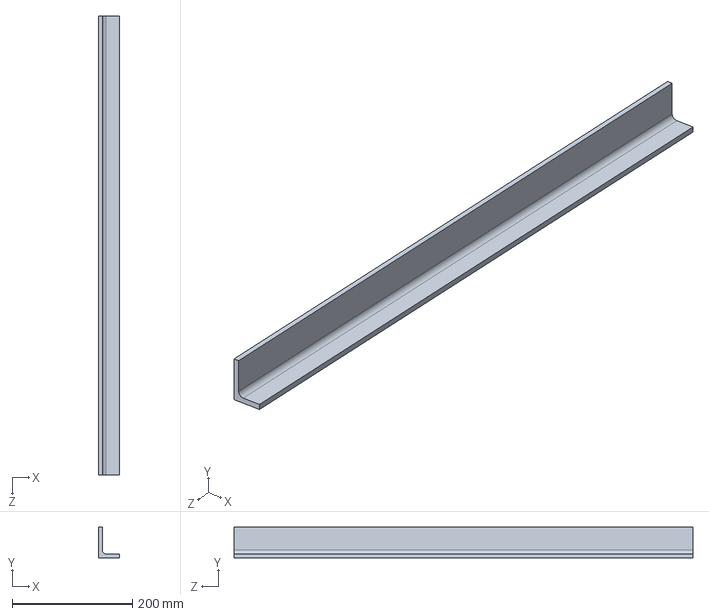
[picture p190: CAD file, 2012-07-12]
Models/A001_Frame-From-Art/A001_LBracket.sldprt
34.9 x 50.8 x 762.0 mm
