pieterpottie/flim-transport-project/Models/A004_Mounts/A004_Frame_LBracket.SLDPRT

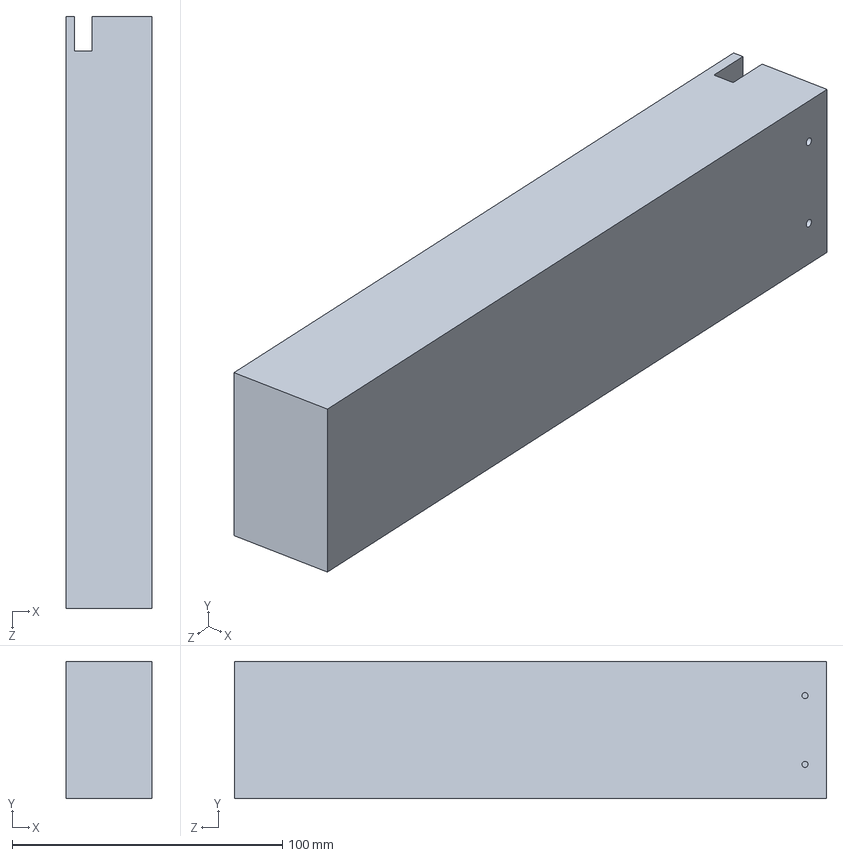
[picture p191: CAD file, 2012-07-12]
Models/A004_Mounts/A004_Frame_LBracket.SLDPRT
32.0 x 50.8 x 219.1 mm
