pieterpottie/flim-transport-project/Andrew Models Import/ANDREW_DCMOTOR_MOUNTS/Ge_Motor.SLDPRT

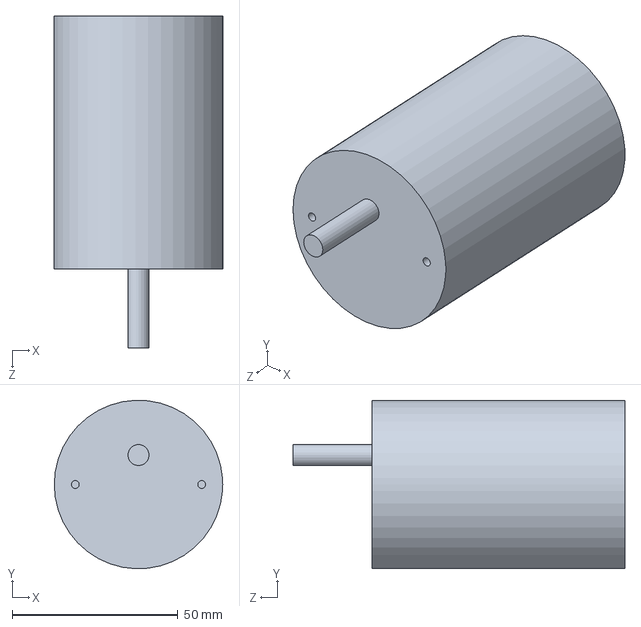
[picture p192: CAD file, 2012-07-03]
Andrew Models Import/ANDREW_DCMOTOR_MOUNTS/Ge_Motor.SLDPRT
50.8 x 50.8 x 100.1 mm
