pieterpottie/flim-transport-project/Andrew Models Import/PrintSprock/OuterSandwich_PressFit.SLDPRT

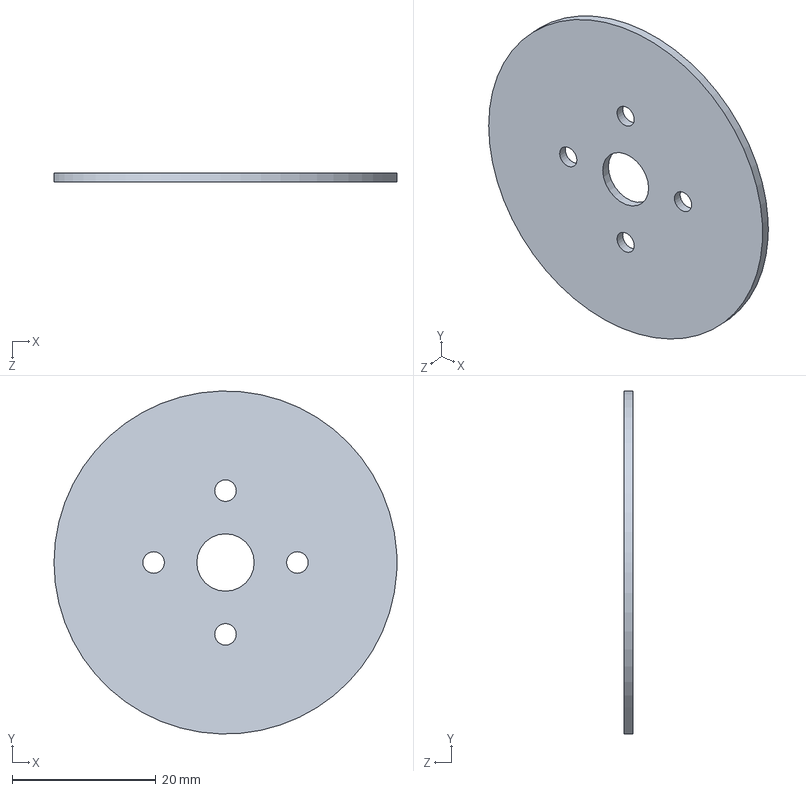
[picture p193: CAD file, 2012-07-03]
Andrew Models Import/PrintSprock/OuterSandwich_PressFit.SLDPRT
47.7 x 47.7 x 1.27 mm
