pieterpottie/flim-transport-project/Andrew Models Import/StructureAngle.SLDPRT

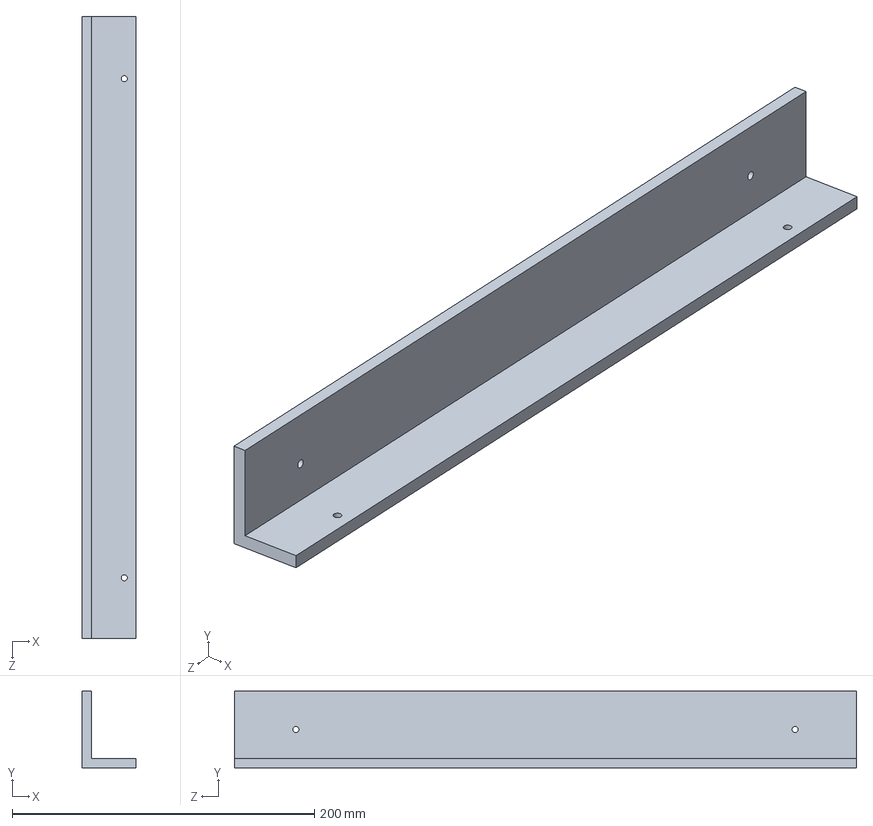
[picture p194: CAD file, 2012-07-05]
Andrew Models Import/StructureAngle.SLDPRT
35.6 x 50.8 x 411.5 mm
