pieterpottie/flim-transport-project/Models/A002_Film-Gate/B003_Design-3/A002-B003_tensioner.sldprt

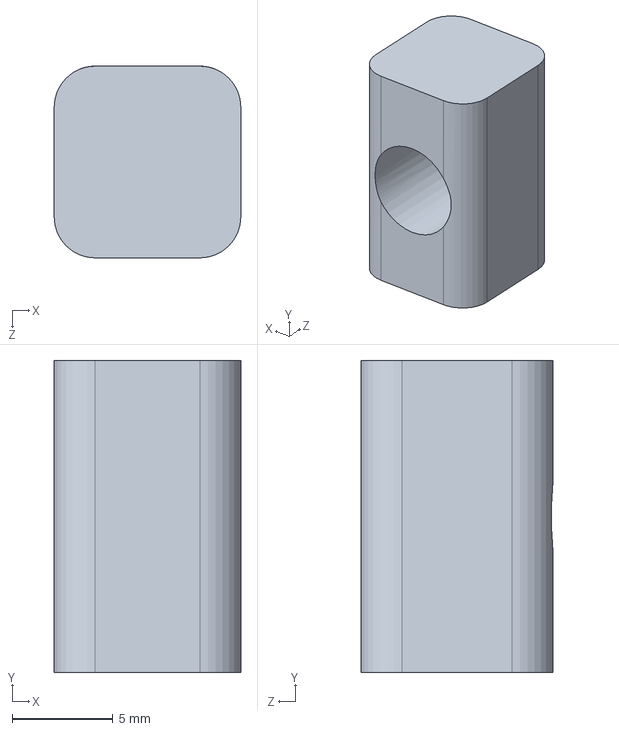
[picture p195: CAD file, 2012-08-03]
Models/A002_Film-Gate/B003_Design-3/A002-B003_tensioner.sldprt
9.27 x 15.5 x 9.53 mm
