pieterpottie/flim-transport-project/Andrew Models Import/PrintSprock/Coupler.SLDPRT

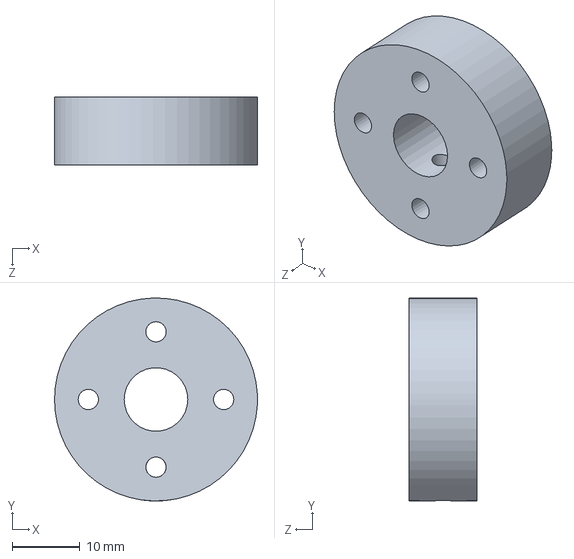
[picture p196: CAD file, 2012-07-03]
Andrew Models Import/PrintSprock/Coupler.SLDPRT
30.0 x 30.0 x 10.0 mm
