pieterpottie/flim-transport-project/Models/A002_Film-Gate/B003_Design-3/A002-B003_base.SLDPRT

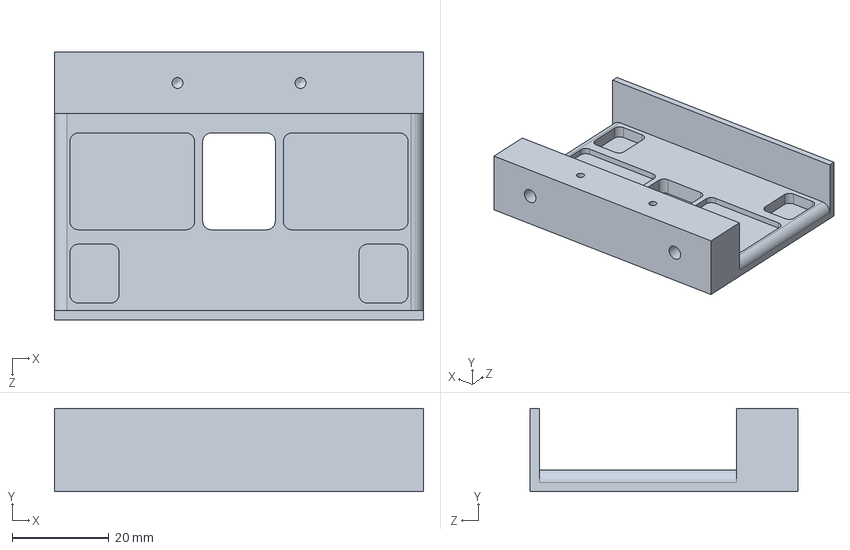
[picture p197: CAD file, 2012-08-03]
Models/A002_Film-Gate/B003_Design-3/A002-B003_base.SLDPRT
76.2 x 17.1 x 55.2 mm
