pieterpottie/flim-transport-project/Models/A004_Mounts/A004_LED-Mount.SLDPRT

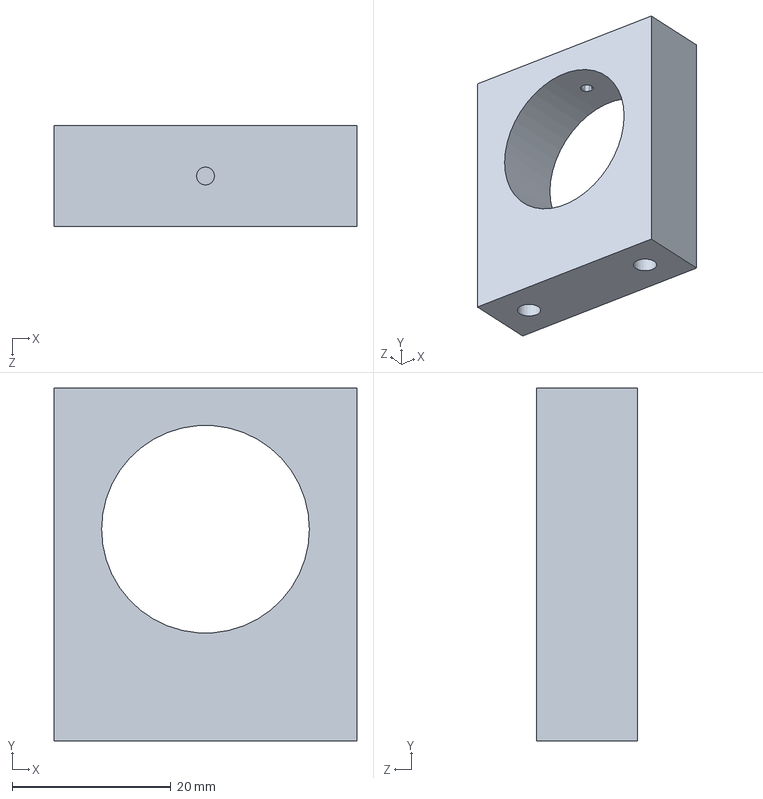
[picture p198: CAD file, 2012-07-12]
Models/A004_Mounts/A004_LED-Mount.SLDPRT
38.1 x 44.5 x 12.7 mm
