pieterpottie/flim-transport-project/Andrew Models Import/PrintSprock/R23.87mmSprocketFine.SLDPRT

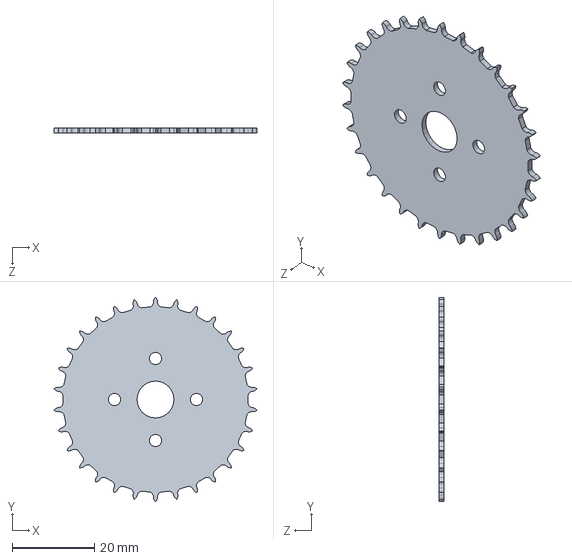
[picture p199: CAD file, 2012-07-03]
Andrew Models Import/PrintSprock/R23.87mmSprocketFine.SLDPRT
49.5 x 49.7 x 1.27 mm
