pieterpottie/flim-transport-project/Models/A002_Film-Gate/B003_Design-3/A002-B003_Brace.SLDPRT

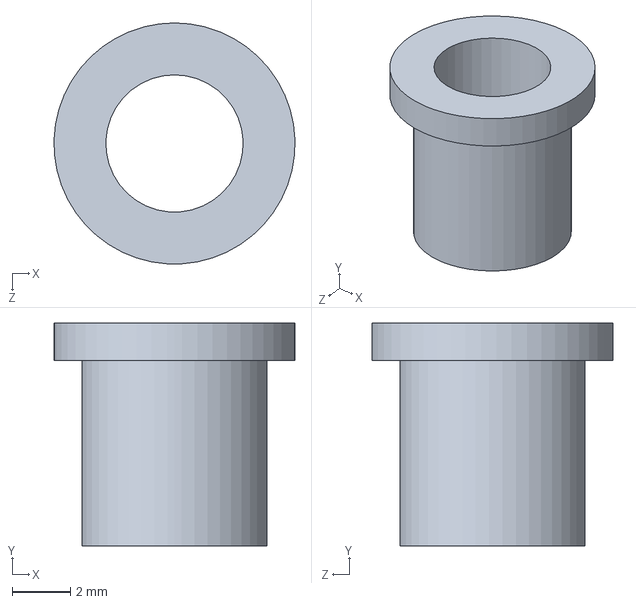
[picture p200: CAD file, 2012-07-12]
Models/A002_Film-Gate/B003_Design-3/A002-B003_Brace.SLDPRT
8.25 x 7.62 x 8.26 mm
