pieterpottie/flim-transport-project/Models/A004_Mounts/A004_Tensioner-bracket.SLDPRT

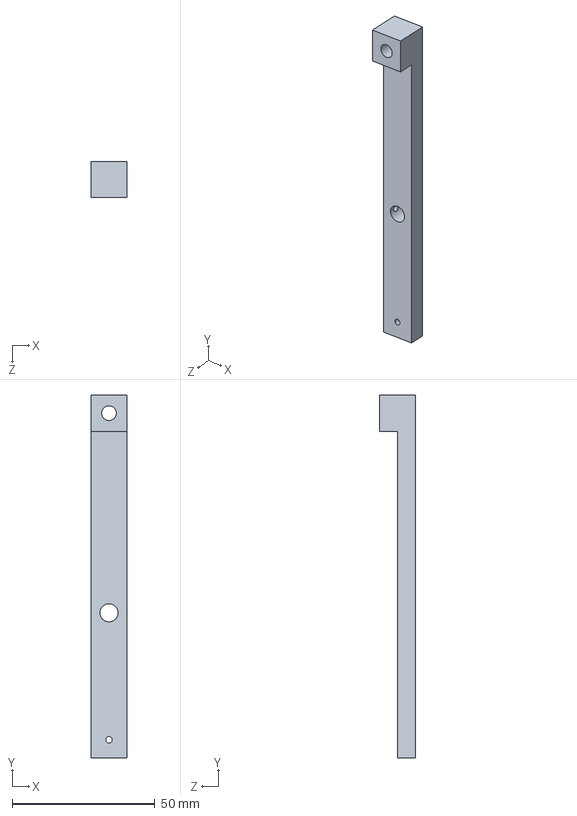
[picture p201: CAD file, 2012-07-12]
Models/A004_Mounts/A004_Tensioner-bracket.SLDPRT
12.7 x 127.0 x 12.7 mm
