pieterpottie/flim-transport-project/Andrew Models Import/PrintSprock/Coupling rod.SLDPRT

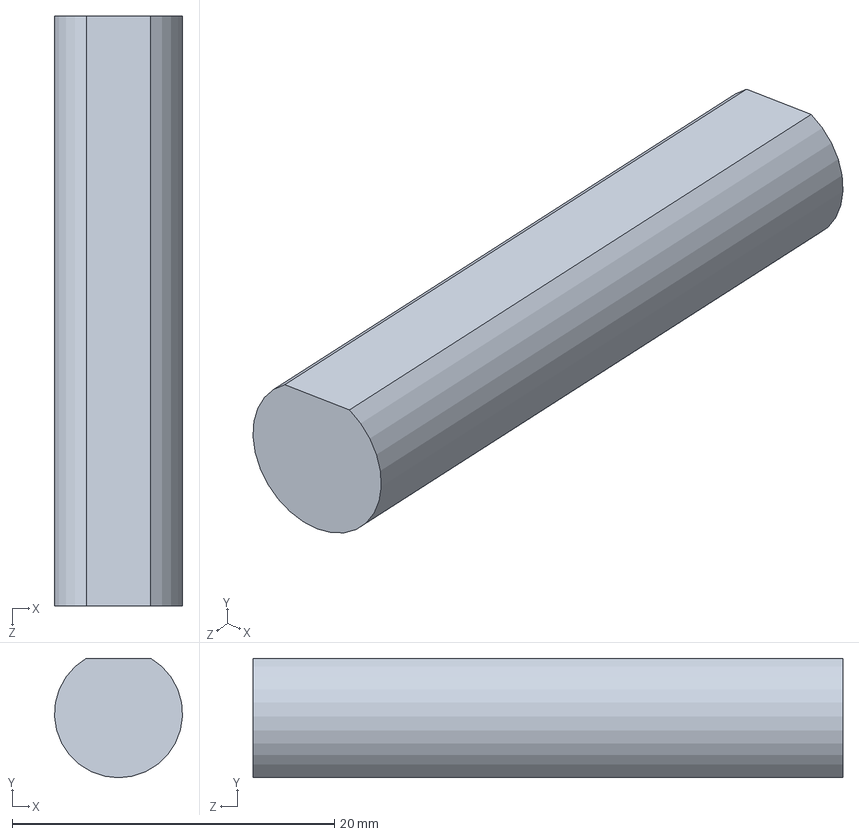
[picture p202: CAD file, 2012-05-28]
Andrew Models Import/PrintSprock/Coupling rod.SLDPRT
7.94 x 7.41 x 36.6 mm
