pieterpottie/flim-transport-project/Andrew Models Import/ReelRod.SLDPRT

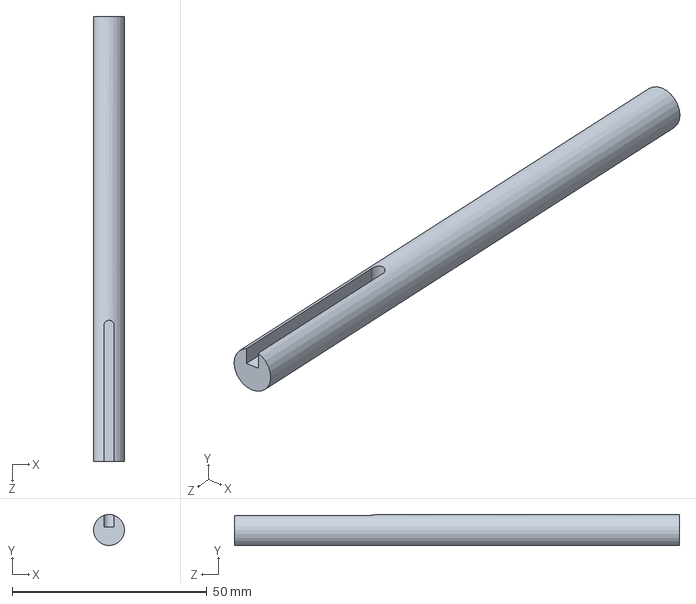
[picture p203: CAD file, 2012-07-03]
Andrew Models Import/ReelRod.SLDPRT
8.00 x 8.00 x 114.3 mm
