pieterpottie/flim-transport-project/Models/A002_Film-Gate/B003_Design-3/A002-B003_spring-2.SLDPRT

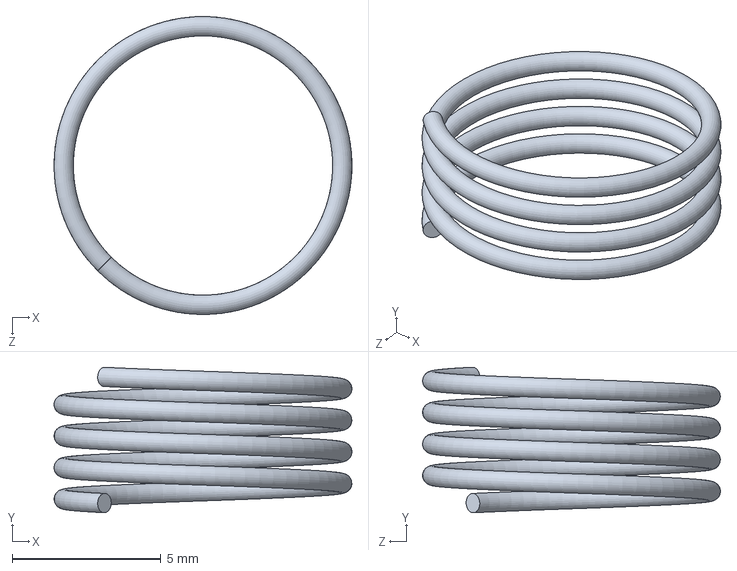
[picture p204: CAD file, 2012-07-03]
Models/A002_Film-Gate/B003_Design-3/A002-B003_spring-2.SLDPRT
10.0 x 4.89 x 10.0 mm
