pieterpottie/flim-transport-project/Models/A004_Mounts/A004_Adapter_Holder2.SLDPRT

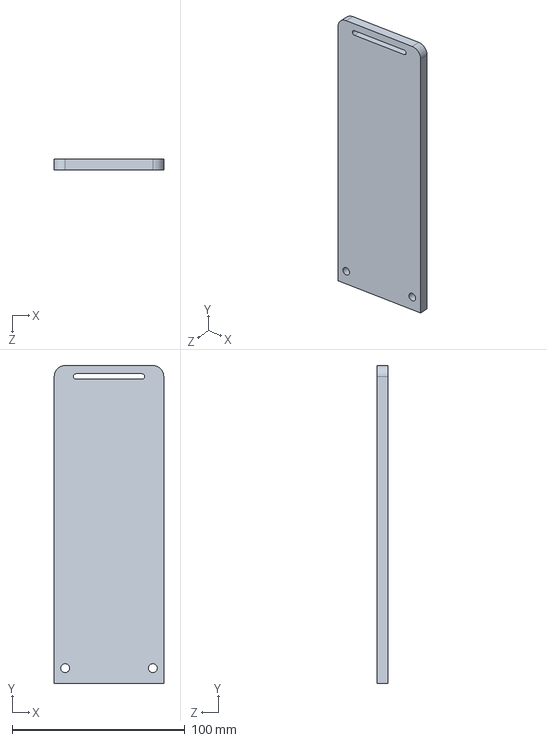
[picture p205: CAD file, 2012-07-12]
Models/A004_Mounts/A004_Adapter_Holder2.SLDPRT
63.5 x 184.1 x 6.35 mm
