pieterpottie/flim-transport-project/Models/A004_Mounts/A004_Camera.SLDPRT

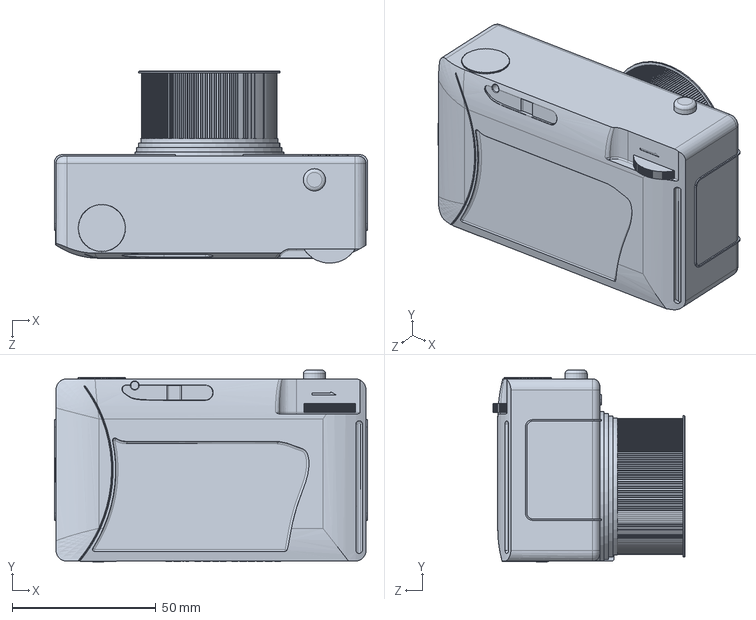
[picture p206: CAD file, 2012-07-05]
Models/A004_Mounts/A004_Camera.SLDPRT
109.0 x 66.8 x 67.0 mm
