pieterpottie/flim-transport-project/Models/A004_Mounts/A004_Camera_LBracket.SLDPRT

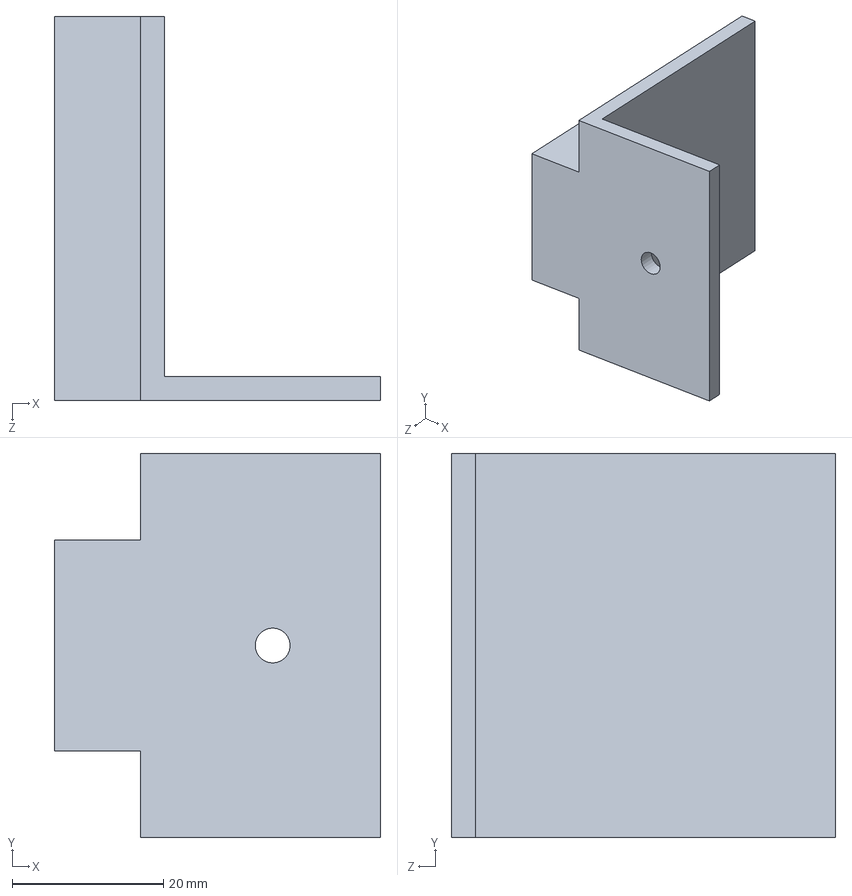
[picture p207: CAD file, 2012-07-05]
Models/A004_Mounts/A004_Camera_LBracket.SLDPRT
43.2 x 50.8 x 50.8 mm
