pieterpottie/flim-transport-project/Andrew Models Import/Potentiometer.SLDPRT

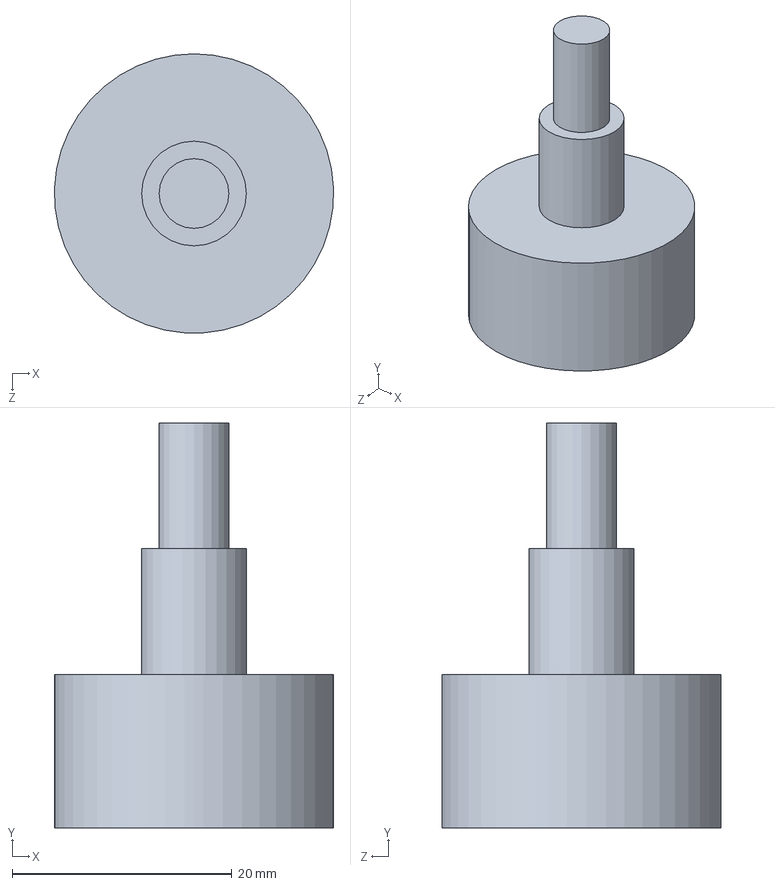
[picture p208: CAD file, 2012-07-03]
Andrew Models Import/Potentiometer.SLDPRT
25.4 x 36.8 x 25.4 mm
