pieterpottie/flim-transport-project/Andrew Models Import/TensionArm.SLDPRT

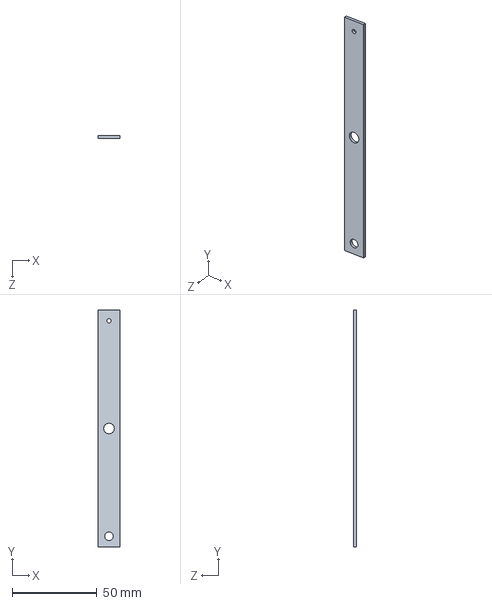
[picture p209: CAD file, 2012-07-03]
Andrew Models Import/TensionArm.SLDPRT
12.7 x 139.7 x 1.59 mm
