pieterpottie/flim-transport-project/Andrew Models Import/SmallPulleyRoller_4mm.SLDPRT

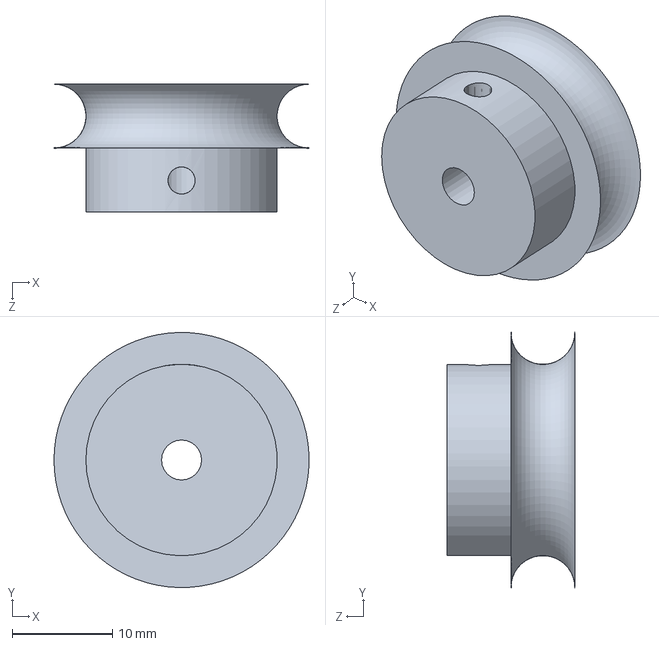
[picture p210: CAD file, 2012-07-03]
Andrew Models Import/SmallPulleyRoller_4mm.SLDPRT
25.4 x 25.4 x 12.7 mm
