pieterpottie/flim-transport-project/Andrew Models Import/R23.87mmSprocketFine.SLDPRT

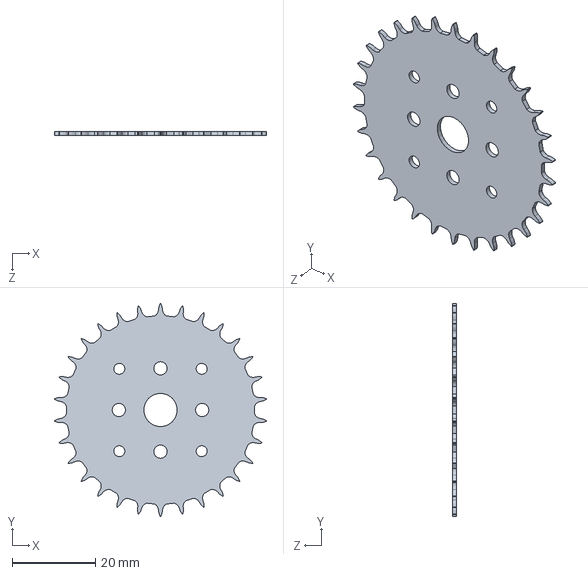
[picture p211: CAD file, 2012-07-03]
Andrew Models Import/R23.87mmSprocketFine.SLDPRT
50.9 x 51.2 x 1.02 mm
