pieterpottie/flim-transport-project/Andrew Models Import/Sprocket_Pin.SLDPRT

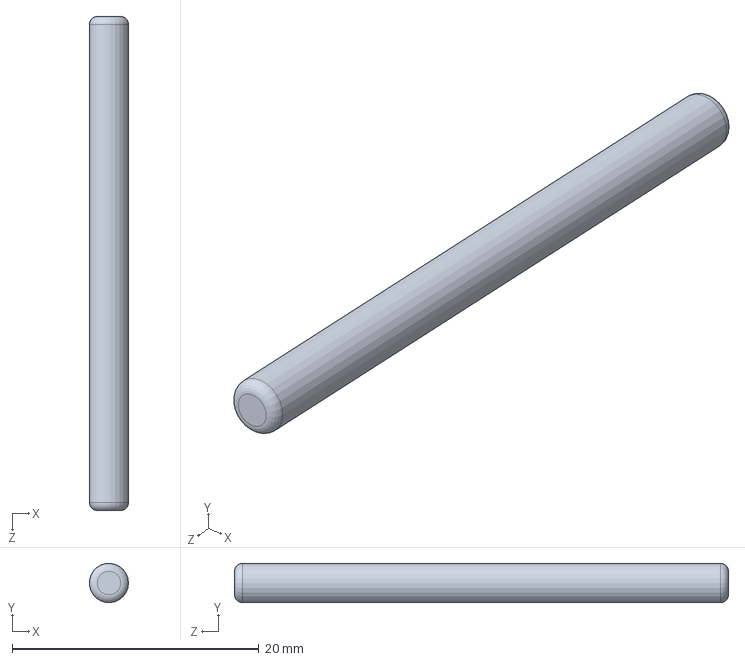
[picture p212: CAD file, 2012-07-03]
Andrew Models Import/Sprocket_Pin.SLDPRT
3.16 x 3.17 x 40.0 mm
