pieterpottie/flim-transport-project/Andrew Models Import/DelrinSpacer.SLDPRT

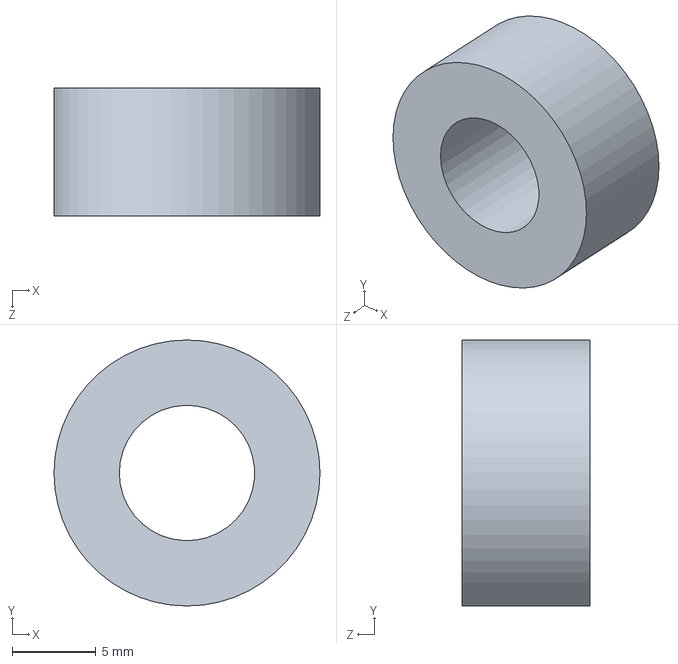
[picture p213: CAD file, 2012-07-03]
Andrew Models Import/DelrinSpacer.SLDPRT
15.9 x 15.9 x 7.62 mm
