pieterpottie/flim-transport-project/Andrew Models Import/R23.87mmSprocketCoarse.SLDPRT

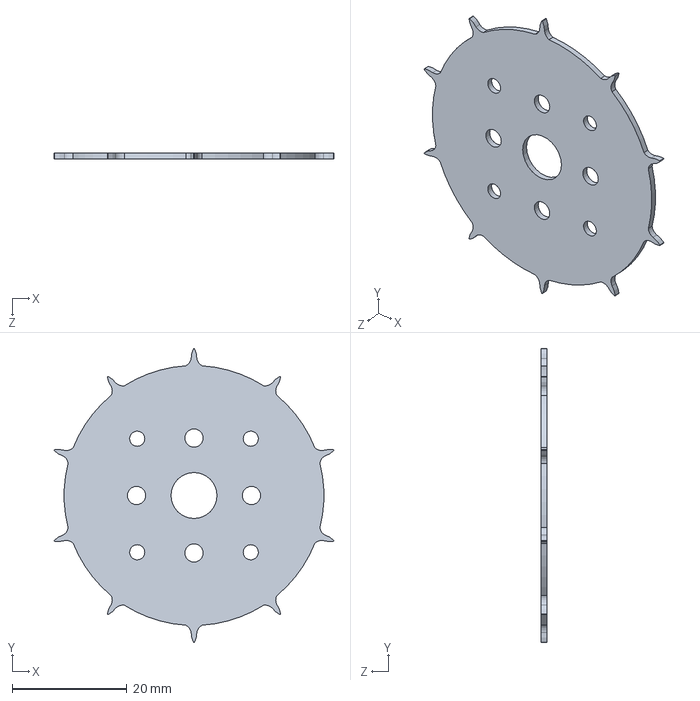
[picture p214: CAD file, 2012-07-03]
Andrew Models Import/R23.87mmSprocketCoarse.SLDPRT
48.6 x 51.1 x 1.02 mm
