pieterpottie/flim-transport-project/Andrew Models Import/RollerPin.SLDPRT

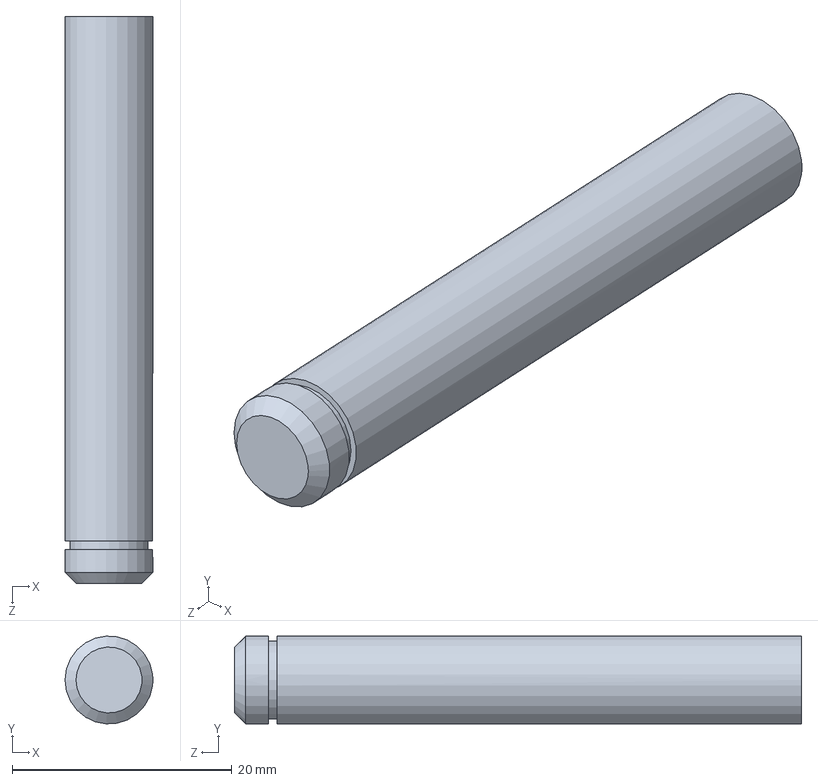
[picture p215: CAD file, 2012-07-03]
Andrew Models Import/RollerPin.SLDPRT
8.00 x 7.98 x 51.6 mm
