pieterpottie/flim-transport-project/Andrew Models Import/RollerPLASTICSECTION.SLDPRT

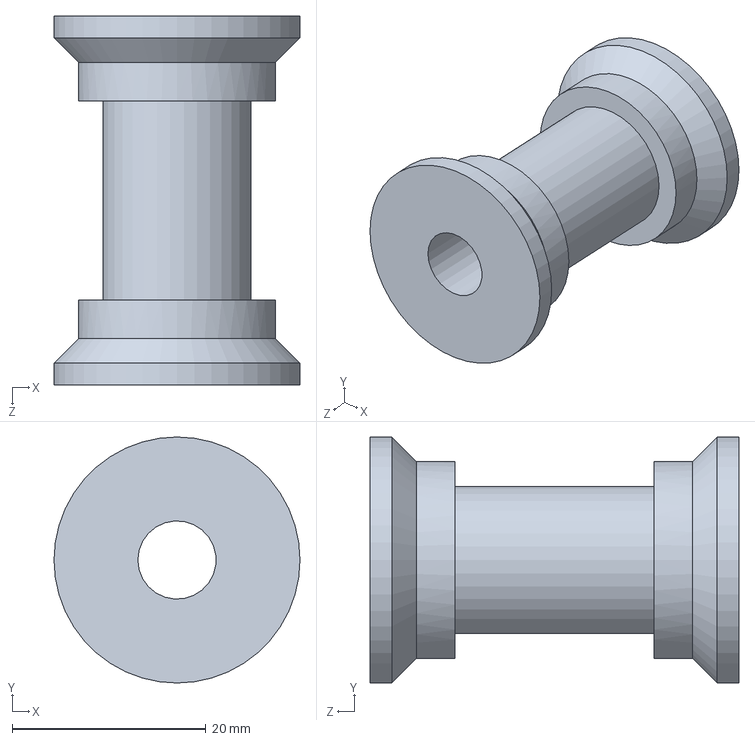
[picture p216: CAD file, 2012-07-03]
Andrew Models Import/RollerPLASTICSECTION.SLDPRT
25.4 x 25.4 x 38.1 mm
