pieterpottie/flim-transport-project/Andrew Models Import/ReelKey.SLDPRT

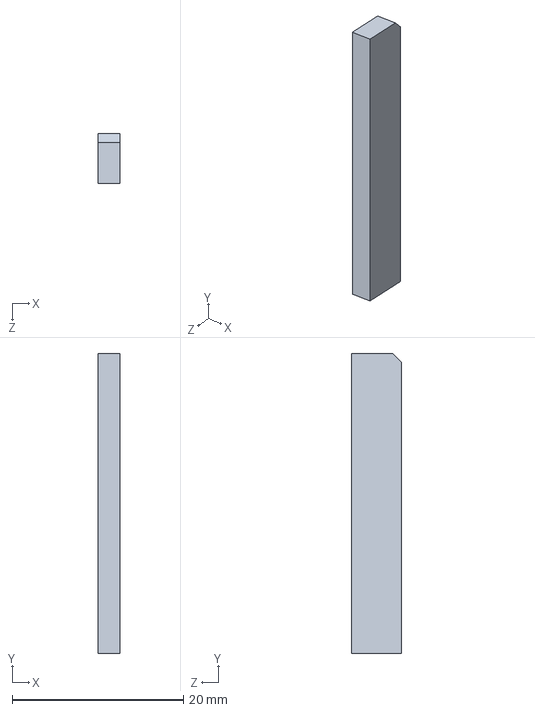
[picture p217: CAD file, 2012-07-03]
Andrew Models Import/ReelKey.SLDPRT
2.60 x 35.0 x 5.78 mm
