pieterpottie/flim-transport-project/Andrew Models Import/LongInnerSpacer.SLDPRT

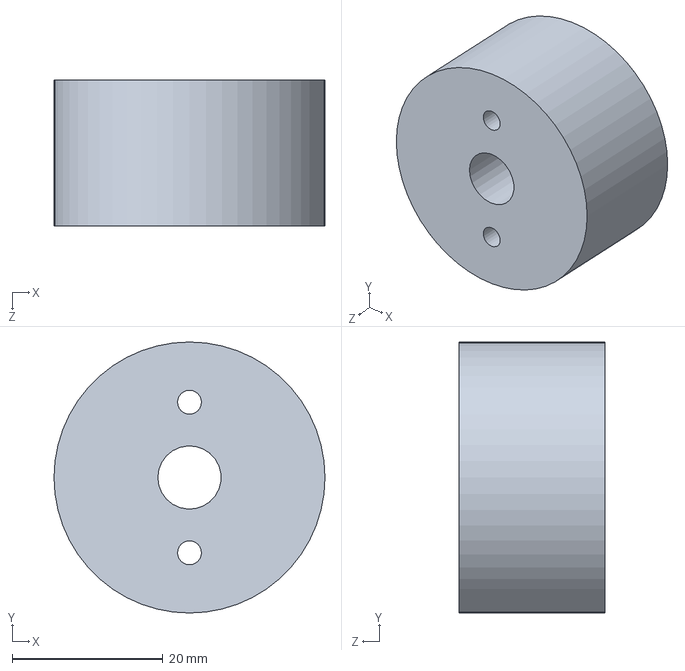
[picture p218: CAD file, 2012-06-24]
Andrew Models Import/LongInnerSpacer.SLDPRT
36.0 x 36.0 x 19.5 mm
