pieterpottie/flim-transport-project/Andrew Models Import/OuterSandwich_THIN.SLDPRT

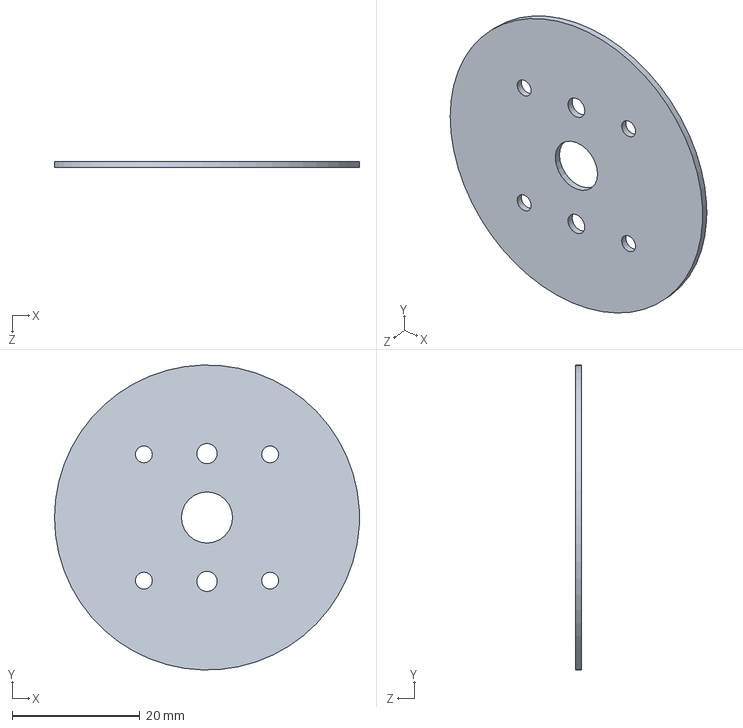
[picture p219: CAD file, 2012-06-24]
Andrew Models Import/OuterSandwich_THIN.SLDPRT
47.7 x 47.7 x 1.02 mm
