pieterpottie/flim-transport-project/Andrew Models Import/OuterSandwich_THICK.SLDPRT

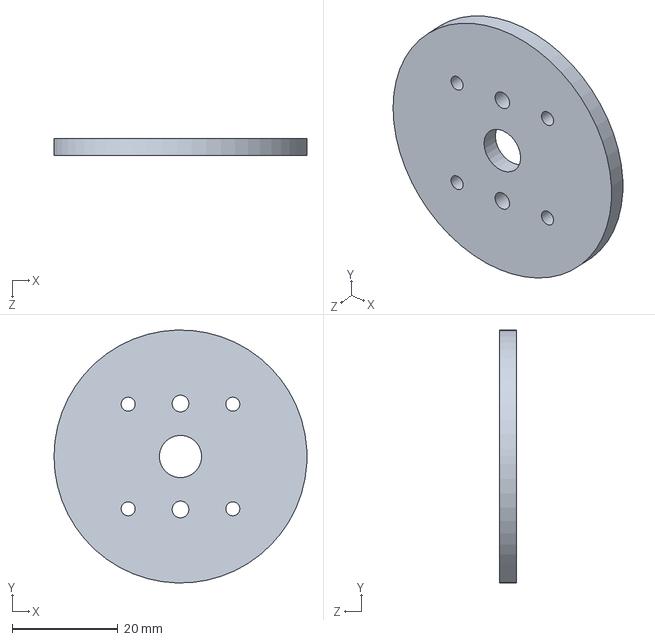
[picture p220: CAD file, 2012-06-24]
Andrew Models Import/OuterSandwich_THICK.SLDPRT
47.7 x 47.7 x 3.17 mm
