pieterpottie/flim-transport-project/Andrew Models Import/LargePulleyRoller.SLDPRT

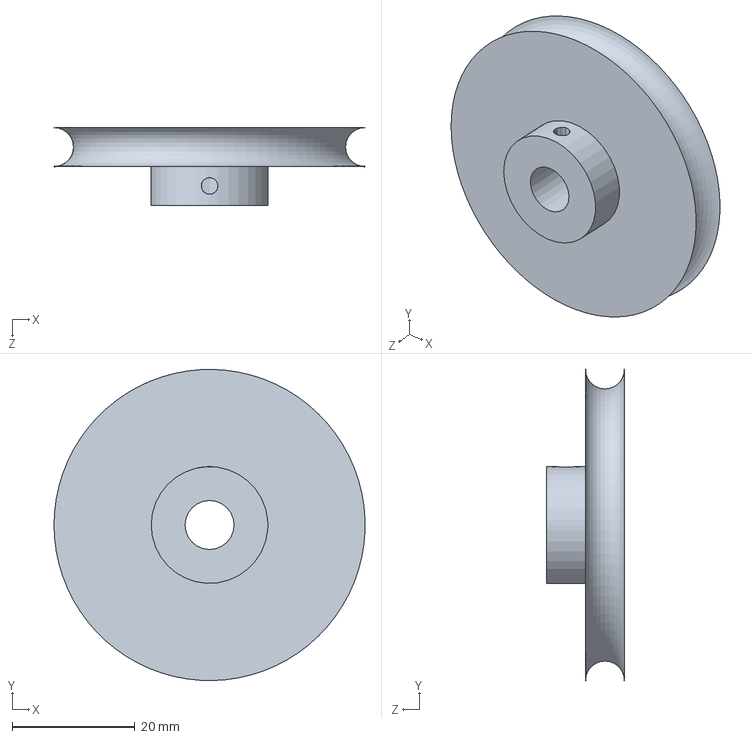
[picture p221: CAD file, 2012-06-24]
Andrew Models Import/LargePulleyRoller.SLDPRT
50.8 x 50.8 x 12.7 mm
