pieterpottie/flim-transport-project/Andrew Models Import/Coupler.SLDPRT

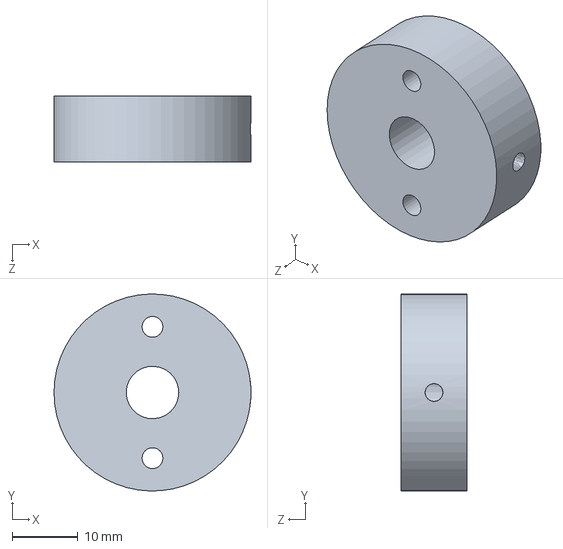
[picture p222: CAD file, 2012-06-24]
Andrew Models Import/Coupler.SLDPRT
30.0 x 30.0 x 10.0 mm
