pieterpottie/flim-transport-project/(list of files, cad)

Other CAD files:
Sketch/DesignFromArt.SLDPRT
Models/A002_Film-Gate/B002_Design-2/A002-B002_base.SLDPRT
Andrew Models Import/ANDREW_DCMOTOR_MOUNTS/Wimpy_Faithful.SLDPRT
Andrew Models Import/PrintSprock/innerSandwich_3quarterdia_looseFit.SLDPRT
Models/A001_Frame-From-Art/A001_base.sldprt
Models/A002_Film-Gate/B001_Design-1/A002-B001_tensioner.sldprt
Models/A002_Film-Gate/B002_Design-2/A002-B002_LEDs.sldprt
Models/A002_Film-Gate/B002_Design-2/A002-B002_LEDMount.sldprt
Models/A002_Film-Gate/B002_Design-2/A002-B002_topTensioner.sldprt
Models/A002_Film-Gate/B002_Design-2/A002-B002_filmModel.SLDPRT
Models/A002_Film-Gate/B003_Design-3/A002-B003_spring.SLDPRT
Models/A002_Film-Gate/B003_Design-3/A002-B003_LEDs.sldprt
Models/A002_Film-Gate/B003_Design-3/A002-B003_LEDMount.sldprt
Models/A002_Film-Gate/B003_Design-3/A002-B003_filmModel.SLDPRT
Andrew Models Import/SmallPulleyRoller.SLDPRT
Andrew Models Import/FilmModel.SLDPRT
Andrew Models Import/6-32_Set_Screw.SLDPRT
Andrew Models Import/ANDREW_DCMOTOR_MOUNTS/GE_restricted.SLDDRW
Andrew Models Import/ANDREW_DCMOTOR_MOUNTS/Wimpy_Faithful.SLDDRW
Andrew Models Import/Coupler.SLDDRW
Andrew Models Import/DelrinSpacer.SLDDRW
Andrew Models Import/DelrinWasher.SLDDRW
Andrew Models Import/DelrinWasher.SLDPRT
Andrew Models Import/FilmModel.SLDDRW
Andrew Models Import/Frame.SLDDRW
Andrew Models Import/LargePulleyRoller.SLDDRW
Andrew Models Import/LongInnerSpacer.SLDDRW
Andrew Models Import/OuterSandwich_THICK.SLDDRW
Andrew Models Import/OuterSandwich_THIN.SLDDRW
Andrew Models Import/PrintSprock/Coupler.STL
Andrew Models Import/PrintSprock/OuterSandwich_PressFit.STL
Andrew Models Import/PrintSprock/R23.87mmSprocketCoarse.STL
Andrew Models Import/PrintSprock/R23.87mmSprocketFine.STL
Andrew Models Import/PrintSprock/innerSandwich_3quarterdia_looseFit.STL
Andrew Models Import/R23.87mmSprocketCoarse.SLDDRW
Andrew Models Import/R23.87mmSprocketFine.SLDDRW
Andrew Models Import/ReelKey.SLDDRW
Andrew Models Import/ReelRod.SLDDRW
Andrew Models Import/RollerPLASTICSECTION.SLDDRW
Andrew Models Import/RollerPin.SLDDRW
Andrew Models Import/SmallPulleyRoller.SLDDRW
Andrew Models Import/StructureAngle.SLDDRW
Andrew Models Import/TensionArm.SLDDRW
Models/A001_Frame-From-Art/A001_screw.SLDPRT
Models/A002_Film-Gate/B002_Design-2/A002-B002_screw.SLDPRT
Models/A002_Film-Gate/B003_Design-3/A002-B003_Brace.SLDDRW
Models/A002_Film-Gate/B003_Design-3/A002-B003_TensionMount.SLDDRW
Models/A002_Film-Gate/B003_Design-3/A002-B003_assem.SLDDRW
Models/A002_Film-Gate/B003_Design-3/A002-B003_base.SLDDRW
Models/A002_Film-Gate/B003_Design-3/A002-B003_screw.SLDPRT
Models/A002_Film-Gate/B003_Design-3/A002-B003_tensioner.SLDDRW
Models/A002_Film-Gate/B003_Design-3/A002-B003_topTensioner.SLDDRW
Models/A004_Mounts/A004_Adapter_Holder.SLDDRW
Models/A004_Mounts/A004_Adapter_Holder2.SLDDRW
Models/A004_Mounts/A004_LED-Mount.SLDDRW
Models/A004_Mounts/A004_Tensioner-bracket.SLDDRW
Models/ANDREW_ROLLERS/DelrinWasher.SLDDRW
Models/ANDREW_ROLLERS/DelrinWasher.SLDPRT
