pieterpottie/flim-transport-project/Design-Reports/Report-2/All/A.pdf

#4-40 2PL R0.07 FILLET 4PL ⁰ 0.5; R0.19 FILLET 2PL; SECTION A-A; SCALE: 1:1; SHEET 1 OF 1; Material:; TITLE:; Aluminum; QTY:

Top Pressure Plate
DWG. NO.
A002-B003_topTensioner
REV: 3

#4-40 CLEARANCE 4PL; Tension Mount; A002-B003_TensionMount; DWG. NO.; Material:; TITLE:; Plexi-glass; QTY:

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

R0.100 FILLET; SECTION A-A; SECTION B-B; TYP FILLETS R0.07; Base Plate; A002-B003_base; DWG. NO.; Material:; TITLE:; Aluminum; QTY:

SCALE: 1:2; SHEET 1 OF 1; Material:; TITLE:; QTY:

ITEM NO. | PART NUMBER | DESCRIPTION | QTY.
1 | A002-B003_base | Base plate | 1
2 | virtualFilmModel^A002-B003_assem | Film Representation | 1

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

Film Gate Assembly
DWG. NO.
A002-B003_assem
