pieterpottie/flim-transport-project/Design-Reports/Report-2/All/B.pdf

Sprocket Pin; Sprocket_Pin; SCALE: 2:1; SHEET 1 OF 1; DWG. NO.; Material:; TITLE:; Steel; QTY:; REV: 1

SolidWorks Educational Edition.
For Instructional Use Only.

6-32 Clear 4Pl; Fine Sprocket; R23.87mmSprocketFine; DWG. NO.; Material:; TITLE:; Aluminium; QTY:

SolidWorks Educational Edition.
For Instructional Use Only.

.1250 THRU 4PL; .3150 THRU; .1040 THRU 4PL; Coarse Sprocket; R23.87mmSprocketCoarse; DWG. NO.; Material:; TITLE:; Aluminium; QTY:

SolidWorks Educational Edition.
For Instructional Use Only.

.104 THRU 4PL; .315 THRU; .125 THRU 2PL; Inner Shoulder; OuterSandwich_THIN; DWG. NO.; Material:; TITLE:; Aluminium; QTY:

SolidWorks Educational Edition.
For Instructional Use Only.

.104 THRU 4PL; .315 THRU; .125 THRU 2PL; Outer Shoulder; OuterSandwich_THICK; DWG. NO.; Material:; TITLE:; Aluminium; QTY:

SolidWorks Educational Edition.
For Instructional Use Only.

Roller Bushing; Delrin_Bushing; DWG. NO.; Material:; TITLE:; Delrin; QTY:

SolidWorks Educational Edition.
For Instructional Use Only.

.315 THRU; .125 THRU 2 PL; #6-32 Tapped Hole; Sprocket Coupler; Coupler; DWG. NO.; Material:; TITLE:; Delrin; QTY:

SolidWorks Educational Edition.
For Instructional Use Only.
