pieterpottie/flim-transport-project/Design-Reports/Report-2/All/C.pdf

10-32 Clear 2PL; Wimpy_Faithful; SCALE: 1:1; SHEET 1 OF 1; DWG. NO.; Material:; TITLE:; Aluminium; QTY:; REV: 1

SolidWorks Educational Edition.
For Instructional Use Only.

Small DC Motor
Mount

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

SolidWorks Educational Edition.
For Instructional Use Only.

Small Pulley Roller
DWG. NO.
SmallPulleyRoller_4mm_4mm

.250 THRU; 6-32 Tapped THRU; Material:; TITLE:; Aluminium; QTY:

SolidWorks Educational Edition.
For Instructional Use Only.

Small Pulley Roller
DWG. NO.
SmallPulleyRoller

Reel Rod; ReelRod; DWG. NO.; Material:; TITLE:; Stainless Steel; QTY:

SolidWorks Educational Edition.
For Instructional Use Only.

Reel Key; ReelKey; DWG. NO.; Material:; TITLE:; Stainless Steel; QTY:

SolidWorks Educational Edition.
For Instructional Use Only.

.315 THRU; 6-32 Tapped THRU; Large Pulley; LargePulleyRoller; DWG. NO.; Material:; TITLE:; Aluminium; QTY:

SolidWorks Educational Edition.
For Instructional Use Only.

#10-32 Tapped Hole; GE_restricted; DWG. NO.; Material:; TITLE:; Aluminium; QTY:

SolidWorks Educational Edition.
For Instructional Use Only.

Large DC Motor
Mount

Reel Bushing; Brass_Bushing; DWG. NO.; Material:; TITLE:; Brass; QTY:

SolidWorks Educational Edition.
For Instructional Use Only.
