pieterpottie/flim-transport-project/Design-Reports/Report-2/All/F.pdf

1.000
0

LED Mount; A004_LED-Mount; SCALE: 1:1; SHEET 1 OF 1; DWG. NO.; Material:; TITLE:; Aluminum; QTY:; REV: 3
