pieterpottie/flim-transport-project/Design-Reports/Report-2/Appendix-A/part1.pdf

#4-40 2PL R0.07 FILLET 4PL 0; R0.19 FILLET 2PL; SECTION A-A; SCALE: 1:1; SHEET 1 OF 1

Top Pressure Plate
DWG. NO.
A002-B003_topTensioner
REV: 3
