pieterpottie/flim-transport-project/Design-Reports/Report-2/Appendix-A/part2.pdf

#4-40 CLEARANCE 4PL; Tension Mount; SCALE: 1:1; SHEET 1 OF 1; DWG. NO.; REV: 3
