pieterpottie/flim-transport-project/Design-Reports/Report-2/Appendix-A/part3.pdf

R0.080 FILLET; SECTION A-A; 0.250 DRILLED 0.250; SIde Tensioner; SCALE: 2:1; SHEET 1 OF 1; DWG. NO.; REV: 3
