pieterpottie/flim-transport-project/Design-Reports/Report-2/Appendix-A/part4.pdf

R0.100 FILLET; SECTION A-A; SECTION B-B; TYP FILLETS R0.07; Base Plate; SCALE: 1:1; SHEET 1 OF 1; DWG. NO.; REV: 4
