pieterpottie/flim-transport-project/Design-Reports/Report-2/Appendix-B/part1.pdf

Sprocket Pin; SCALE: 2:1; SHEET 1 OF 1; DWG. NO.; REV: 1

SolidWorks Educational Edition.
For Instructional Use Only.
