pieterpottie/flim-transport-project/Design-Reports/Report-2/Appendix-B/part2.pdf

6-32 Clear 4Pl; Fine Sprocket; SCALE: 2:1; SHEET 1 OF 1; DWG. NO.; REV: 1

SolidWorks Educational Edition.
For Instructional Use Only.
