pieterpottie/flim-transport-project/Design-Reports/Report-2/Appendix-C/part2.pdf

.157 THRU; 6-32 Tapped THRU; SCALE: 2:1; SHEET 1 OF 1

SolidWorks Educational Edition.
For Instructional Use Only.

Small Pulley Roller
DWG. NO.
SmallPulleyRoller_4mm_4mm
REV: 1
