pieterpottie/flim-transport-project/Design-Reports/Report-2/Appendix-C/part4.pdf

Reel Rod; SCALE: 1:1; SHEET 1 OF 1; DWG. NO.; Stainless Steel; REV: 1

SolidWorks Educational Edition.
For Instructional Use Only.
