pieterpottie/flim-transport-project/Design-Reports/Report-2/Appendix-C/part6.pdf

.315 THRU; 6-32 Tapped THRU; Large Pulley; SCALE: 1:1; SHEET 1 OF 1; DWG. NO.; REV: 1

SolidWorks Educational Edition.
For Instructional Use Only.
