pieterpottie/flim-transport-project/Design-Reports/Report-2/Appendix-D/part2.pdf

#10-32 Tapped Hole 0.5dp; Roller Pin; SCALE: 1:1; SHEET 1 OF 1; DWG. NO.; Stainless Steel; REV: 1

SolidWorks Educational Edition.
For Instructional Use Only.
