pieterpottie/flim-transport-project/Design-Reports/Report-2/Appendix-E/part1.pdf

10-24 CLEARANCE THRU; Tensioner Arm; SCALE: 1:2; SHEET 1 OF 1; DWG. NO.; REV: 1

SolidWorks Educational Edition.
For Instructional Use Only.
