pieterpottie/flim-transport-project/Design-Reports/Report-2/Appendix-F/part1.pdf

LED Mount; SCALE: 1:1; SHEET 1 OF 1; DWG. NO.; REV: 3
