pieterpottie/flim-transport-project/Design-Reports/Report-2/Appendix-G/Frame.pdf

10-32 TAPPED THRU 2PL; 6-32 TAPPED THRU; 3/8-24 Tapped Hole; SCALE: 1:4; SHEET 1 OF 1; DWG. NO.; REV: 1

TYP HOLE 10-32 CLEARANCE
