pieterpottie/flim-transport-project/Design-Reports/Report-2/All/H.pdf

PAGE; DRAWN BY:; Arduino MC; ANALOG IN; PWM 1; DC Motor; 5 Phase; Motor Controller; Contrast V0; 2− 120VAC; Anderson Li

955 POWER SUPPLY ACAC 5VDC GND

To Camera Control

Motor Stepper Motor

ENGR 466 Film Transport Electronics Diagram
