pieterpottie/flim-transport-project/Design-Reports/Report-1/Overal Sketch.pdf

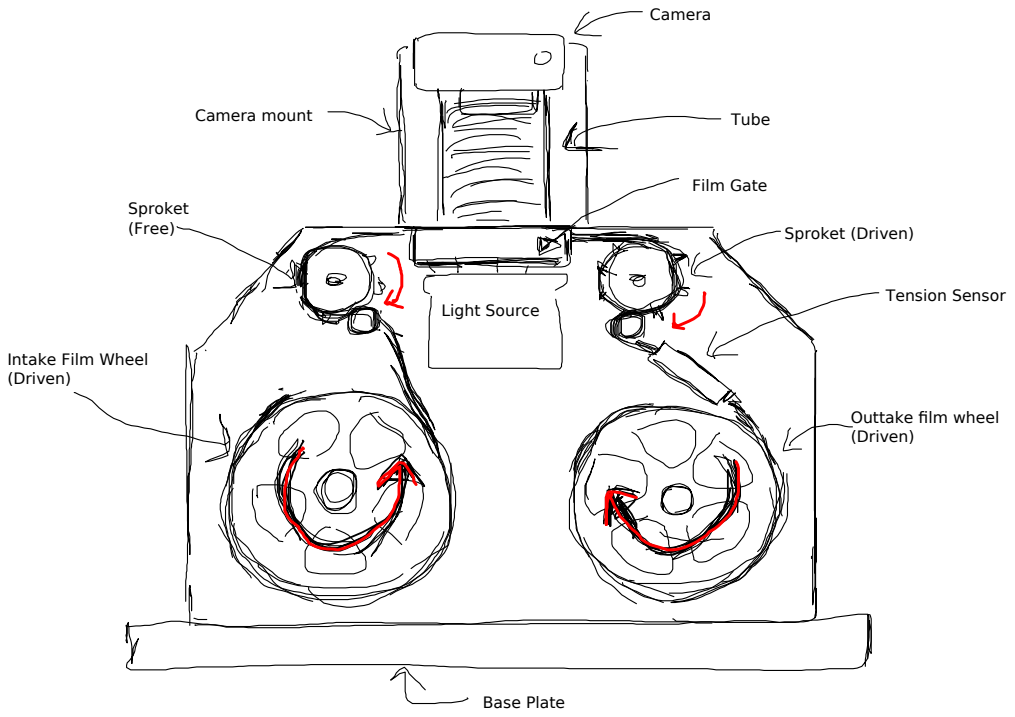
[picture p223: page 1]
'EQIVE; 7TVSOIX(VMZIR; 0MKLX7SYVGI; 'EQIVEQSYRX; 8YFI; &EWI4PEXI; 3YXXEOIPQ[LIIP (VMZIR; 8IRWMSR7IRWSV; *MPQ+EXI; 7TVSOIX *VII

-RXEOI*MPQ;LIIP
(VMZIR
