pieterpottie/flim-transport-project/Design-Reports/Report-2/Appendix-B/part4.pdf

.104 THRU 4PL; .315 THRU; .125 THRU 2PL; Inner Shoulder; SCALE: 2:1; SHEET 1 OF 1; DWG. NO.; REV: 1

SolidWorks Educational Edition.
For Instructional Use Only.
