pieterpottie/flim-transport-project/Models/A002_Film-Gate/B002_Design-2/A002-B002_assem.PDF

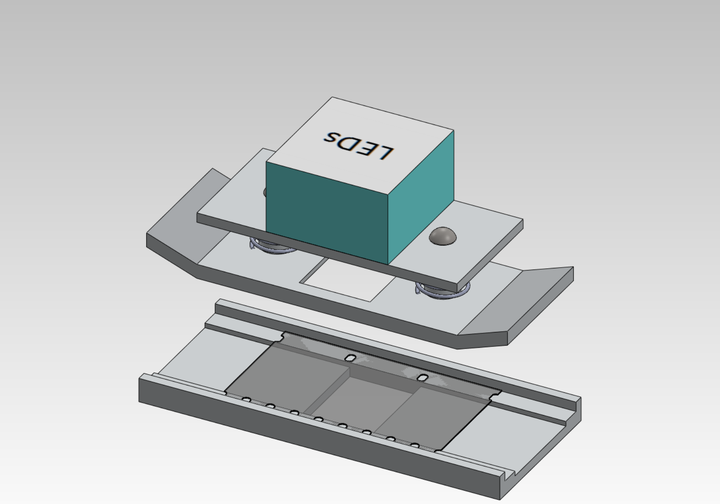
[picture p224: page 1]
