pieterpottie/flim-transport-project/Models/A002_Film-Gate/B003_Design-3/A002-B003_assem.PDF

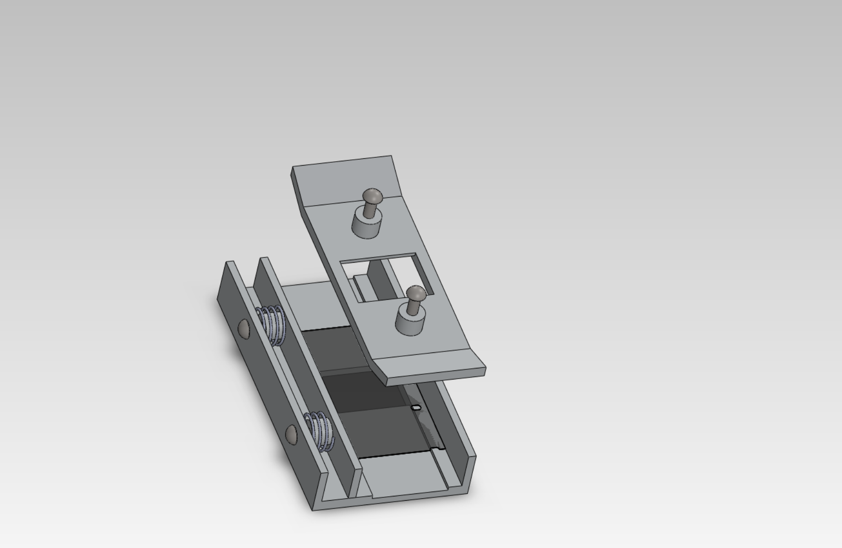
[picture p225: page 1]
