pieterpottie/flim-transport-project/Arduino/ProjectController/StepperMotor.cpp

/*
 * StepperMotor.cpp
 *
 *  Created on: 2012-07-16
 *      Author: anderson
 */
#include "StepperMotor.h"

StepperMotor::StepperMotor(uint8_t pins, uint8_t pin1, uint8_t pin2, uint8_t pin3,uint8_t pin4) : AccelStepper(pins, pin1, pin2, pin3, pin4)
{
	//constructor
}

void StepperMotor::advanceFrame(int frameLength)
{
	this->moveTo(this->currentPosition()+frameLength);
}

void StepperMotor::reverseFrame(int speed)
{
	this->setSpeed(speed);
}
