pieterpottie/flim-transport-project/(commit log)

2012-05-15 First Weekly report
    [Gantt-Chart.xlsx]
2012-05-15 Updates to prelim Gantt
    [Gantt-Chart2.xlsx]
2012-05-15 Added andrew's version
    [Gantt-Chart.xlsx]
2012-05-16 Removed the extra gantt chart
    [Gantt-Chart2.xlsx]
2012-05-16 Added andrew's models
    [FilmModel.SLDDRW, FilmModel.SLDPRT]
2012-05-18 Added a folder for sketches
    [DesignFromArt.SLDPRT]
2012-05-18 Added the solidworks model of what the frame looks like at the moment
    [assemArt.SLDASM, prtBase.sldprt, prtFrame.SLDPRT, prtLBracket.sldprt, prtScrew.SLDPRT]
2012-05-22 Deleted the previous art frame folder. Added a new 2 new folders with the new convention naming system. One of the folders contains design 1 for the film gate.
    [A001_LBracket.sldprt, A001_assem.SLDASM, A001_base.sldprt, A001_frame.SLDPRT, A001_screw.SLDPRT, A002-B001_assem.SLDASM, A002-B001_base.SLDPRT, A002-B001_filmModel.SLDPRT]
2012-05-22 Adjustments to the springs
    [A001_assem.SLDASM, A001_frame.SLDPRT, A002-B001_assem.SLDASM, A002-B001_base.SLDPRT, A002-B001_screw.SLDPRT, A002-B001_spring.SLDPRT, A002_assemDesign1.SLDASM]
2012-05-22 added the new gantt chart and weekly report
    [Gantt-Chart.xlsx]
2012-05-23 Updated the drawing with an LED
    [A002-B001_LEDMount.sldprt, A002-B001_LEDs.sldprt, A002-B001_assem.SLDASM, A002-B001_spring.SLDPRT]
2012-05-24 added 2nd Design for the film gate
    [A002-B002_LEDMount.sldprt, A002-B002_LEDs.sldprt, A002-B002_assem.SLDASM, A002-B002_base.SLDPRT, A002-B002_filmModel.SLDPRT, A002-B002_screw.SLDPRT, A002-B002_spring.SLDPRT, A002-B002_topTensioner.sldprt]
2012-05-24 Added the third design
    [A002-B003_LEDMount.sldprt, A002-B003_LEDs.sldprt, A002-B003_assem.SLDASM, A002-B003_base.SLDPRT, A002-B003_filmModel.SLDPRT, A002-B003_screw.SLDPRT, A002-B003_spring.SLDPRT, A002-B003_tensioner.sldprt]
2012-05-26 updated design report. Rearranged folders
    [A002-B002_LEDMount.sldprt, A002-B002_LEDs.sldprt, A002-B002_assem.SLDASM, A002-B002_base.SLDPRT, A002-B002_filmModel.SLDPRT, A002-B002_screw.SLDPRT, A002-B002_spring.SLDPRT, A002-B002_topTensioner.sldprt]
2012-05-28 added sprocket models, design report 1, and weekly report 3
    [Coupling_rod.SLDPRT, FilmModel.SLDPRT, MajorSprocket23mm.SLDPRT, MinorSprocket23mm.SLDPRT, OuterSandwich_PressFit.SLDPRT, SprocketAssembly.SLDASM, Sprocket_Calculations.xlsx, StepperModel.SLDPRT]
2012-06-05 Updated the film gate models for 3d printing.
    [A002-B003_assem.SLDASM, A002-B003_base.SLDPRT, A002-B003_tensioner.sldprt, A002-B003_topTensioner.sldprt]
2012-06-12 updated the design to make it more machine friendly.
    [A002-B003_assem.SLDASM, A002-B003_base.SLDPRT, A002-B003_spring.SLDPRT, A002-B003_tensioner.sldprt, A002-B003_topTensioner.sldprt]
2012-06-12 updated gantt chart and added weekly report 4
    [Gantt-Chart.xlsx]
2012-06-12 Added the weekly report 5 and the missing Tension mount part.
    [A002-B003_TensionMount.SLDPRT]
2012-06-17 Added drawings for the film gate
    [A002-B003_TensionMount.SLDDRW, A002-B003_TensionMount.SLDPRT, A002-B003_assem.SLDASM, A002-B003_base.SLDDRW, A002-B003_base.SLDPRT, A002-B003_spring-2.SLDPRT, A002-B003_spring.SLDPRT, A002-B003_tensioner.SLDDRW]
2012-06-18 added frame and led mounts
    [A003_Existing_Art_Frame.SLDASM, A004_LED-Mount.SLDPRT]
2012-06-19 updated my film gate drawings to meet rodney's standards
    [A002-B003_TensionMount.SLDDRW, A002-B003_TensionMount.SLDPRT, A002-B003_assem.SLDASM, A002-B003_base.SLDDRW, A002-B003_base.SLDPRT, A002-B003_spring-2.SLDPRT, A002-B003_tensioner.SLDDRW, A002-B003_topTensioner.SLDDRW]
2012-06-19 Uploaded the electronics schematics and the programming flowchart.
    [Electronic_Schematics.sch, Programming_Flowchart.xlsx]
2012-06-24 added folders with drawings and models for: the sprocket, the pulleys, and the rollers.... roller spacers and pins are not yet added as they need to be completed
    [Coupler.SLDDRW, Coupler.SLDPRT, Coupling_rod.SLDPRT, DelrinSpacer.SLDDRW, DelrinWasher.SLDDRW, DelrinWasher.SLDPRT, LargePulleyRoller.SLDDRW, LargePulleyRoller.SLDPRT]
2012-06-24 deleted some duplicate stuff
    [Coupler.SLDDRW, DelrinSpacer.SLDDRW, LongInnerSpacer.SLDDRW, OuterSandwich_THICK.SLDDRW, OuterSandwich_THIN.SLDDRW, R23.87mmSprocketCoarse.SLDDRW, R23.87mmSprocketFine.SLDDRW]
2012-06-26 added weekly-report-7
    [Gantt-Chart.xlsx]
2012-06-30 Added the electonic schematic pdf
2012-07-03 Updated drawings before report writing
    [A002-B003_Post.SLDPRT, A002-B003_TensionMount.SLDDRW, A002-B003_TensionMount.SLDPRT, A002-B003_assem.SLDASM, A002-B003_base.SLDDRW, A002-B003_base.SLDPRT, A002-B003_screw.SLDPRT, A002-B003_spring-2.SLDPRT]
2012-07-03 fixed assembly
    [A002-B003_assem.SLDDRW]
2012-07-03 updated the models
    [A002-B003_base.SLDPRT, Frame.SLDPRT, ReelAssembly.SLDASM, SprocketAssembly.SLDASM, TelecineAssembly.SLDASM]
2012-07-05 Update after 2nd report
    [A004_Camera.SLDPRT, A004_CameraAssembly.SLDASM, A004_Camera_LBracket.SLDPRT, A004_Frame_LBracket.SLDPRT, A004_LED-Mount.SLDDRW, A004_LED-Mount.SLDPRT, Base.SLDPRT, Electronic_Schematics.sch]
2012-07-12 Updated the assembly
    [A001_LBracket.sldprt, A001_assem.SLDASM, A001_base.sldprt, A001_frame.SLDPRT, A002-B003_Brace.SLDDRW, A002-B003_Brace.SLDPRT, A002-B003_Post.SLDPRT, A002-B003_TensionMount.SLDPRT]
2012-07-16 upload arduino lib
2012-07-16 uploaded PID controller
2012-07-17 updated the gant chart
    [Gantt-Chart.xlsx]
2012-08-03 latest model update
    [A002-B003_Post.SLDPRT, A002-B003_TensionMount.SLDPRT, A002-B003_assem.SLDASM, A002-B003_base.SLDPRT, A002-B003_tensioner.sldprt, A002-B003_topTensioner.sldprt, A003_FrameDesign2.SLDASM, A004_Adapter_Holder.SLDDRW]
